ddomurad/dd8/hardware/gfx_module/README.md

GFX_DMA - Direct Memory Access circuit. Responsible for copping data from CPU RAM into Video RAM.
GFX_VGA - VGA signal generator circuit. Responsible for dumping Video RAM data to VGA display. 
Video RAM - 64KB of RAM that stores the pixel data for the VGA display.
Color Palette RAM - 1K of RAM that stores the color palette for the VGA display.
