ddomurad/dd8/hardware/gfx_module/docs/insp/NewFile1.csv

X | CH1 | CH2 | CH3 | CH4 | Start | Increment
Sequence | Volt | Volt | Volt | Volt | -6.000000e-07 | 1.000000e-09
0 | 4.96e+00 | 2.24e+00 | 8.00e-01 | -1.20e+00
1 | 4.96e+00 | 2.24e+00 | 8.00e-01 | -1.20e+00
2 | 4.80e+00 | 2.48e+00 | 2.08e+00 | -1.28e+00
3 | 4.80e+00 | 2.48e+00 | 2.08e+00 | -1.28e+00
4 | 4.64e+00 | 3.20e+00 | 2.80e+00 | -1.44e+00
5 | 4.64e+00 | 3.20e+00 | 2.80e+00 | -1.44e+00
6 | 4.24e+00 | 3.92e+00 | 2.80e+00 | -1.28e+00
7 | 4.24e+00 | 3.92e+00 | 2.80e+00 | -1.28e+00
8 | 3.52e+00 | 4.16e+00 | 2.88e+00 | -8.00e-01
9 | 3.52e+00 | 4.16e+00 | 2.88e+00 | -8.00e-01
10 | 2.64e+00 | 4.24e+00 | 3.44e+00 | -3.20e-01
11 | 2.64e+00 | 4.24e+00 | 3.44e+00 | -3.20e-01
12 | 1.44e+00 | 4.32e+00 | 4.40e+00 | -2.40e-01
13 | 1.44e+00 | 4.32e+00 | 4.40e+00 | -2.40e-01
14 | 4.80e-01 | 4.64e+00 | 4.88e+00 | -3.20e-01
15 | 4.80e-01 | 4.64e+00 | 4.88e+00 | -3.20e-01
16 | -8.00e-02 | 4.80e+00 | 4.72e+00 | -3.20e-01
17 | -8.00e-02 | 4.80e+00 | 4.72e+00 | -3.20e-01
18 | -3.20e-01 | 4.72e+00 | 4.56e+00 | 8.00e-02
19 | -3.20e-01 | 4.72e+00 | 4.56e+00 | 8.00e-02
20 | -1.60e-01 | 4.56e+00 | 4.40e+00 | 4.80e-01
21 | -1.60e-01 | 4.56e+00 | 4.40e+00 | 4.80e-01
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
