ddomurad/dd8/hardware/gfx_module/docs/insp/NewFile2.csv

X | CH1 | CH2 | CH3 | CH4 | Start | Increment
Sequence | Volt | Volt | Volt | Volt | -6.000000e-07 | 4.000000e-09
0 | 8.00e-01 | -1.12e+00 | -1.68e+00 | 3.52e+00
1 | -4.00e-01 | -1.04e+00 | -1.28e+00 | 3.52e+00
2 | 8.00e-02 | -7.20e-01 | -9.60e-01 | 2.96e+00
3 | 6.40e-01 | -5.60e-01 | -8.00e-01 | 2.40e+00
4 | 2.16e+00 | -2.40e-01 | 0.00e+00 | 2.32e+00
5 | 4.40e+00 | 2.40e-01 | -1.60e-01 | 1.60e-01
6 | 4.96e+00 | 1.92e+00 | -4.00e-01 | -1.12e+00
7 | 4.80e+00 | 2.40e+00 | 2.08e+00 | -1.28e+00
8 | 4.24e+00 | 3.84e+00 | 2.72e+00 | -1.28e+00
9 | 2.64e+00 | 4.16e+00 | 3.44e+00 | -3.20e-01
10 | 4.80e-01 | 4.56e+00 | 4.80e+00 | -3.20e-01
11 | -3.20e-01 | 4.64e+00 | 4.48e+00 | 8.00e-02
12 | 8.00e-02 | 4.40e+00 | 4.40e+00 | 8.80e-01
13 | 8.80e-01 | 3.84e+00 | 3.84e+00 | 7.20e-01
14 | 2.32e+00 | 3.36e+00 | 3.60e+00 | 4.80e-01
15 | 4.24e+00 | 3.12e+00 | 4.00e+00 | 1.84e+00
16 | 5.20e+00 | 8.80e-01 | 4.24e+00 | 2.96e+00
17 | 5.12e+00 | 7.20e-01 | 1.68e+00 | 3.44e+00
18 | 4.00e+00 | 3.20e-01 | 8.00e-01 | 3.68e+00
19 | 2.56e+00 | -5.60e-01 | 3.20e-01 | 3.68e+00
20 | 8.00e-01 | -1.12e+00 | -1.68e+00 | 3.52e+00
21 | -4.00e-01 | -1.04e+00 | -1.28e+00 | 3.52e+00
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
