ddomurad/dd8/hardware/0v2/doc/ic_selector.png

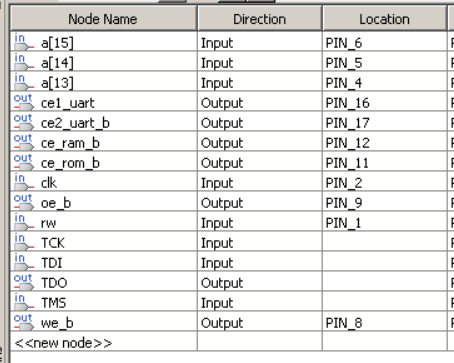
hardware/0v2/doc/ic_selector.png
