ddomurad/dd8/hardware/gfx_module/docs/addr_mux.png

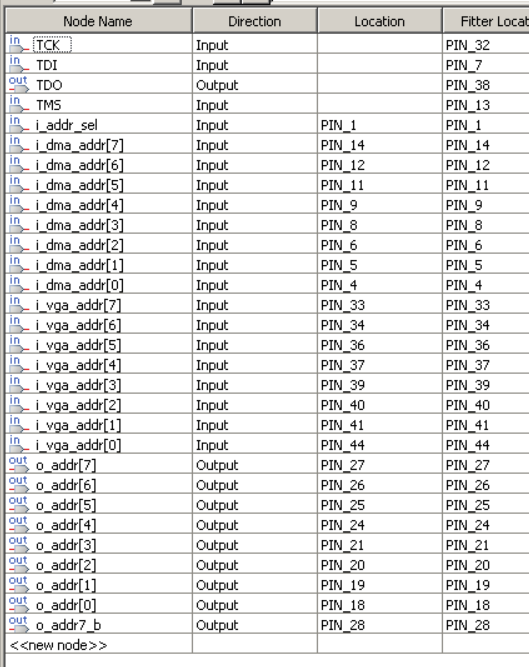
hardware/gfx_module/docs/addr_mux.png
