ddomurad/dd8/hardware/gfx_module/docs/dma_1.png

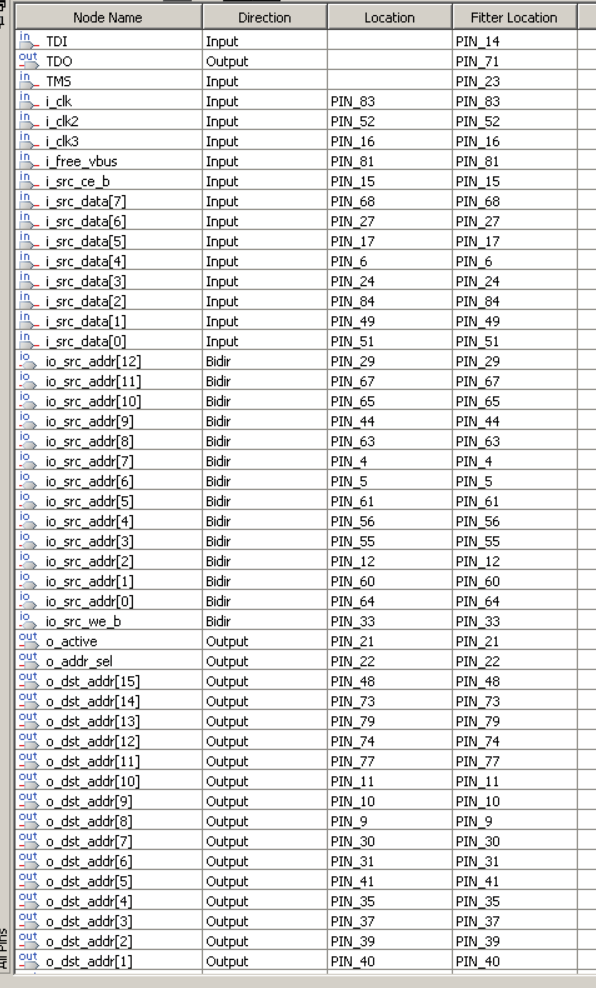
hardware/gfx_module/docs/dma_1.png
