ddomurad/dd8/hardware/gfx_module/docs/insp/NewFile1.png

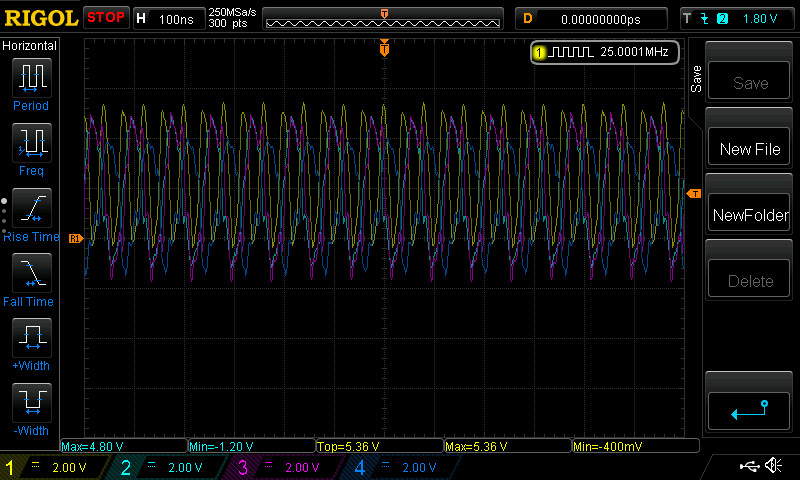
hardware/gfx_module/docs/insp/NewFile1.png
