ddomurad/dd8/hardware/gfx_module/docs/insp/scr1.png

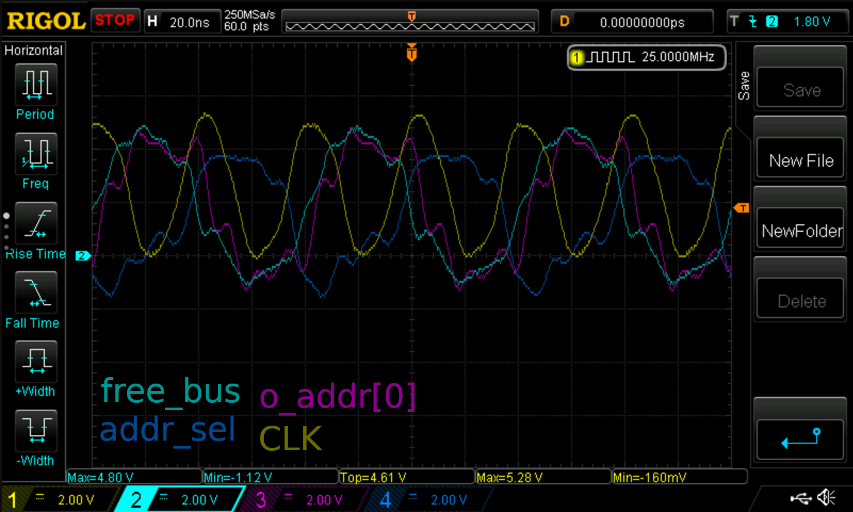
hardware/gfx_module/docs/insp/scr1.png
