ddomurad/dd8/hardware/gfx_module/docs/other/dma_vga-2.png

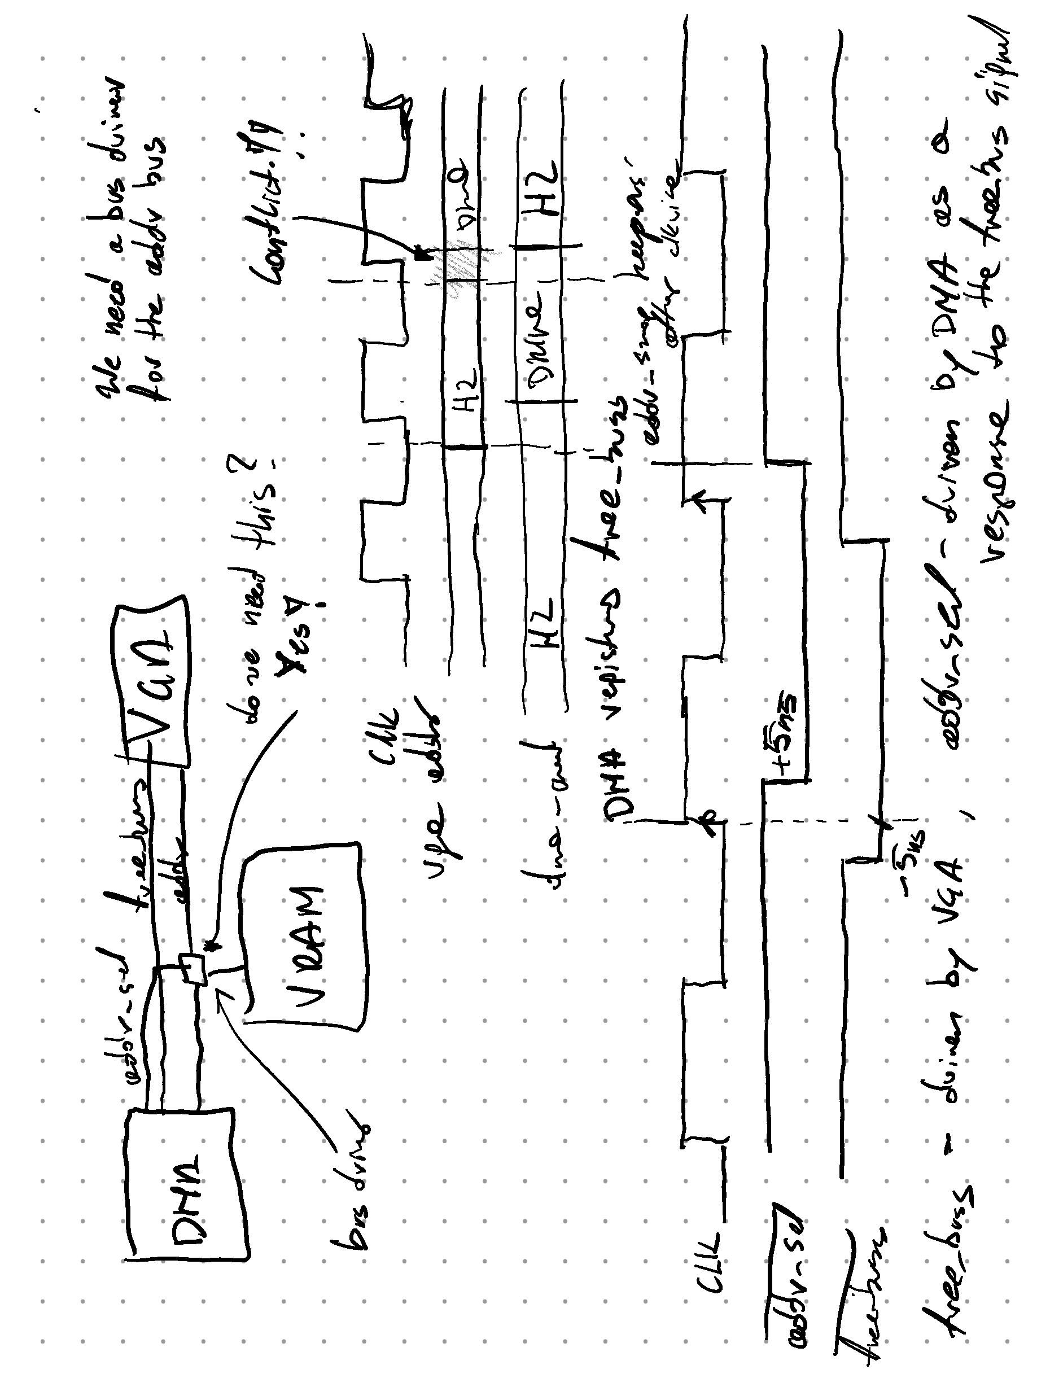
hardware/gfx_module/docs/other/dma_vga-2.png
