ddomurad/dd8/hardware/gfx_module/docs/other/dma_vga-3.png

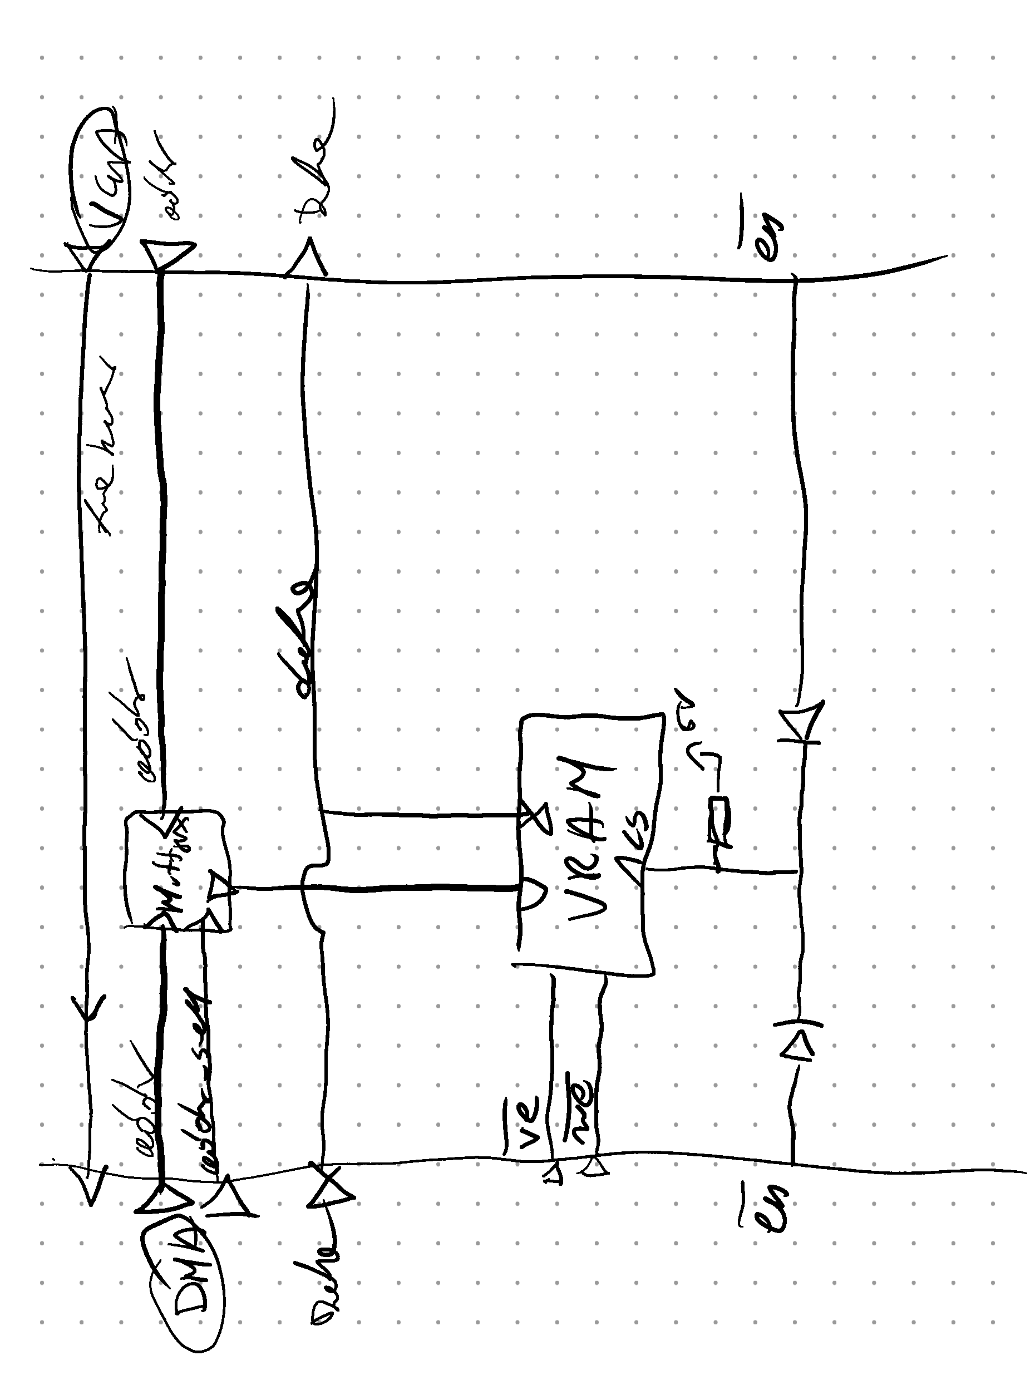
hardware/gfx_module/docs/other/dma_vga-3.png
