ddomurad/dd8/hardware/gfx_module/docs/other/dma_vga-4.png

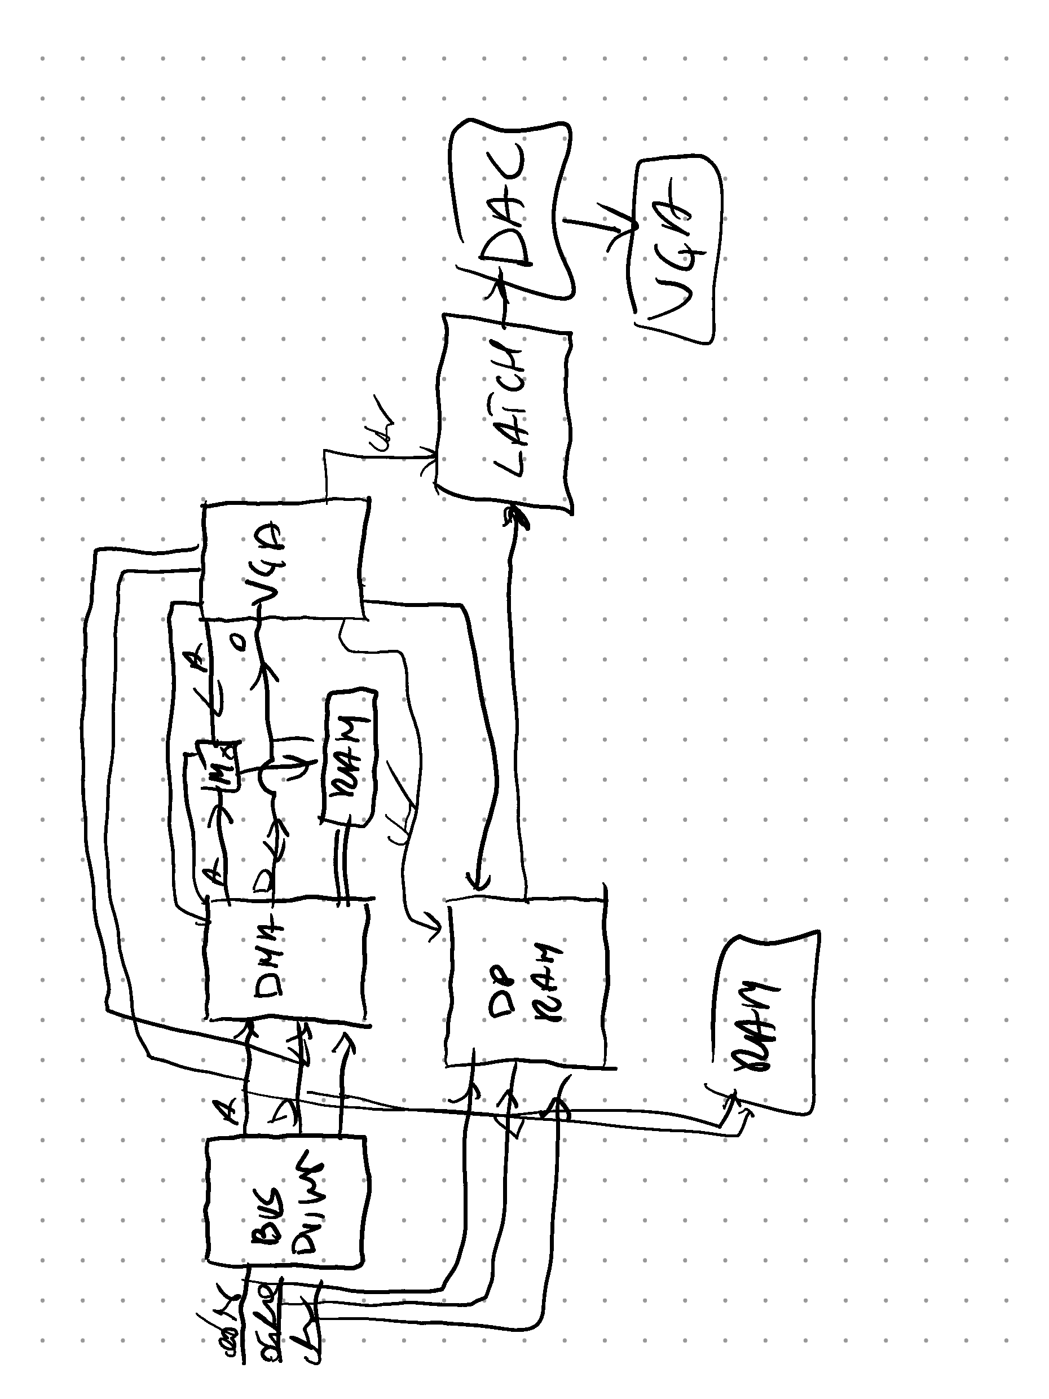
hardware/gfx_module/docs/other/dma_vga-4.png
