ddomurad/dd8/hardware/gfx_module/docs/vga_1.png

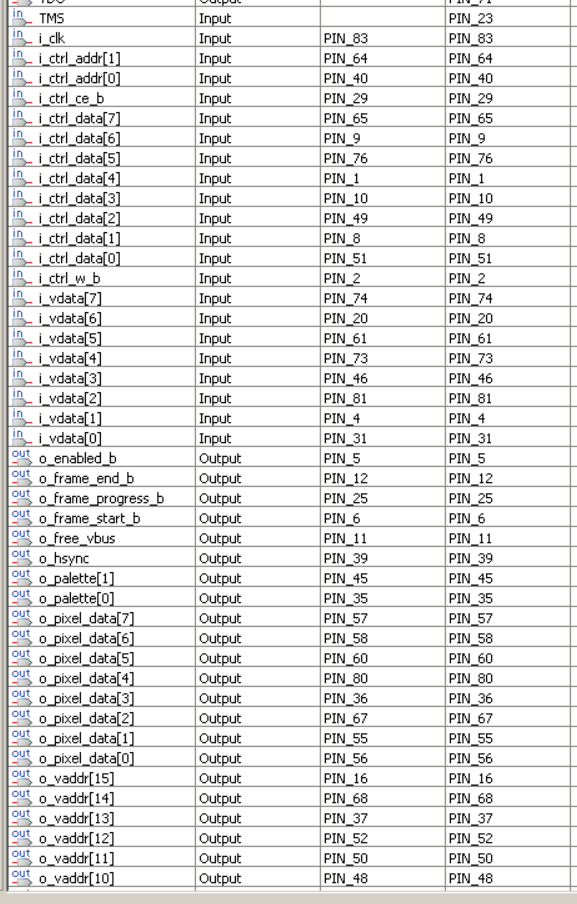
hardware/gfx_module/docs/vga_1.png
