ddomurad/dd8/hardware/gfx_module/docs/vga_2.png

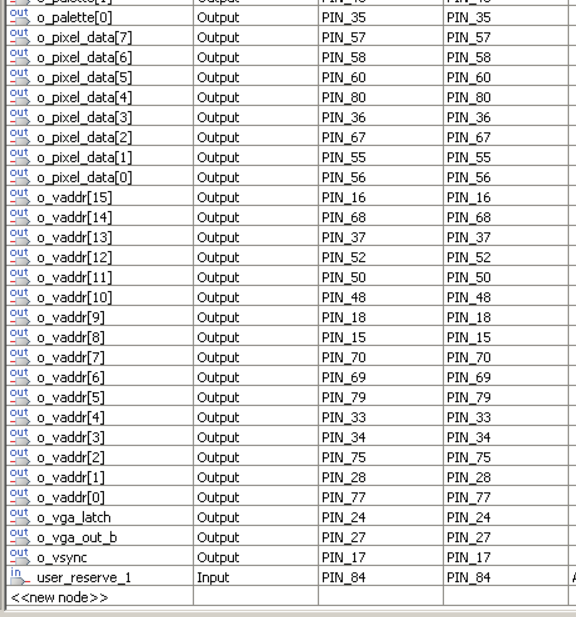
hardware/gfx_module/docs/vga_2.png
