ddomurad/dd8/hardware/kicad/dd8_computer/dd8_computer.pdf

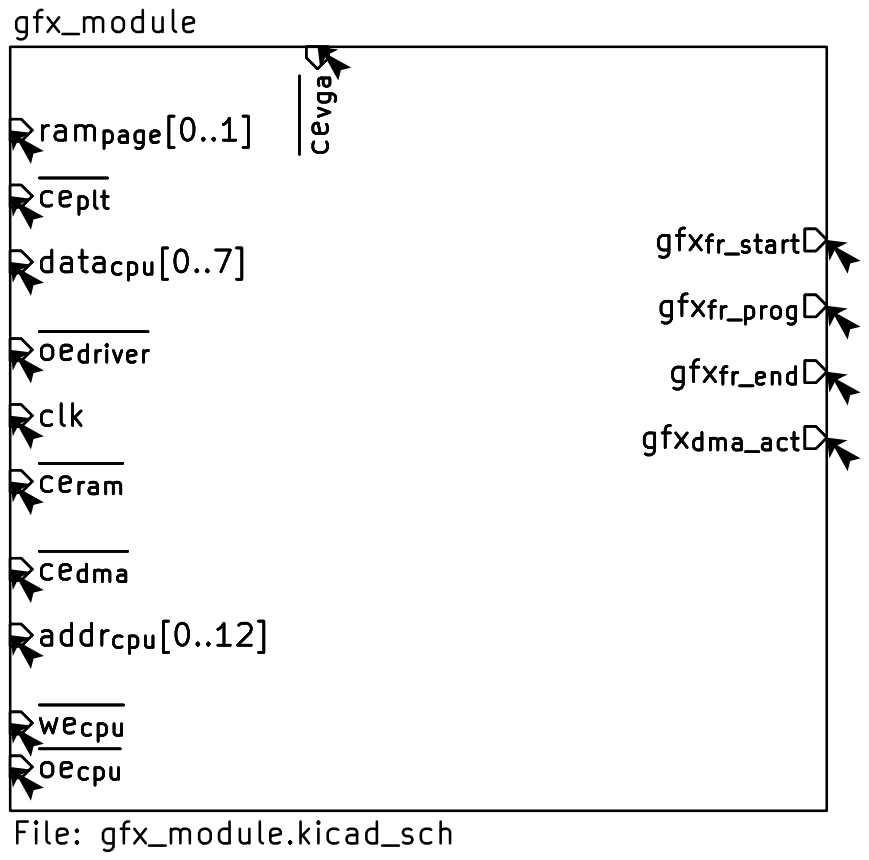
[picture p12: page 1]

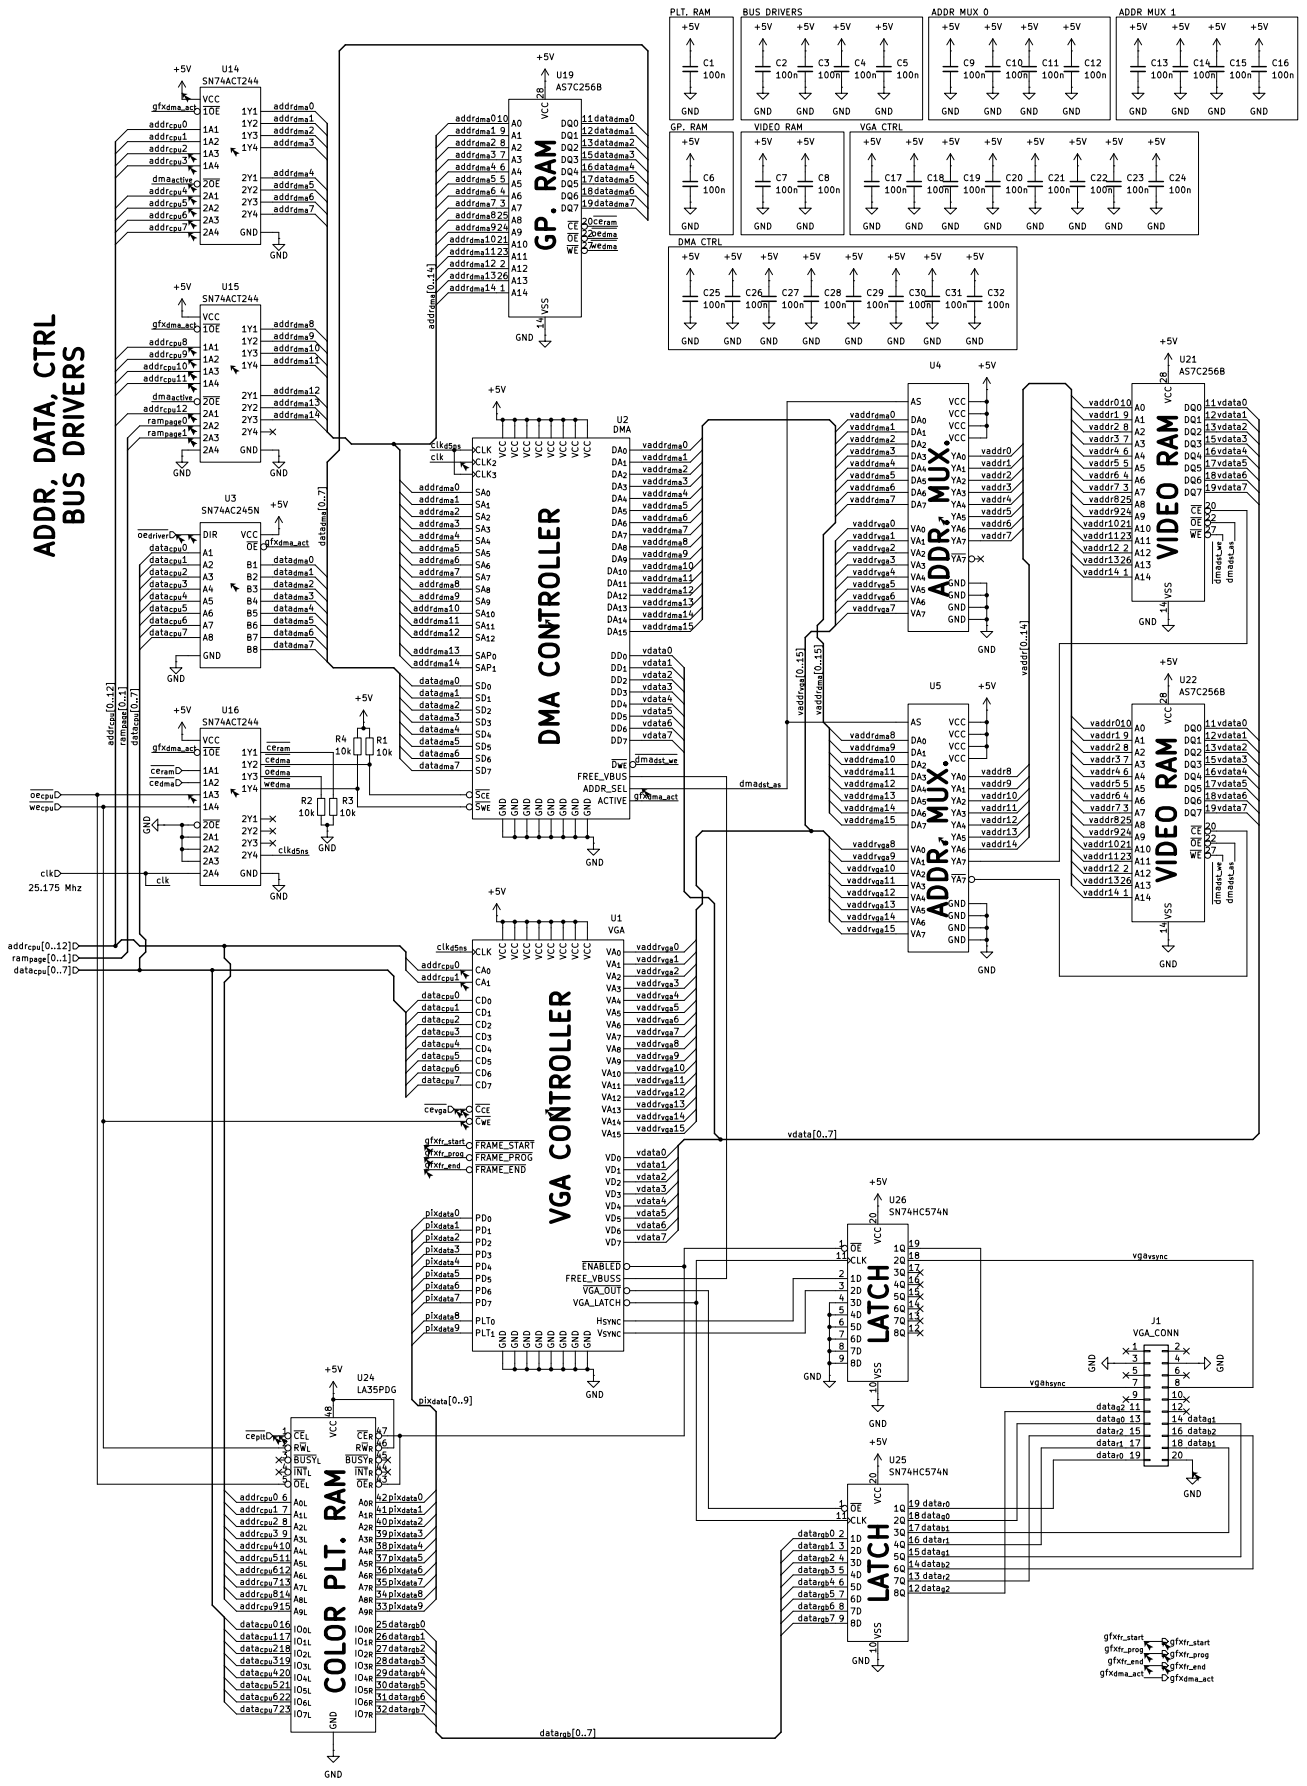
[picture p13: page 2]
