ddomurad/dd8/(list of files, drawings)

Other design files:
hardware/0v2/dd8_0v2/freerouting.dsn
