ddomurad/dd8/tools/hardware/EPMDevBoard/EpmDevBoard/EpmDevBoard.kicad_pcb

## KiCad design tools/hardware/EPMDevBoard/EpmDevBoard/EpmDevBoard.kicad_pcb (2024-11-05)

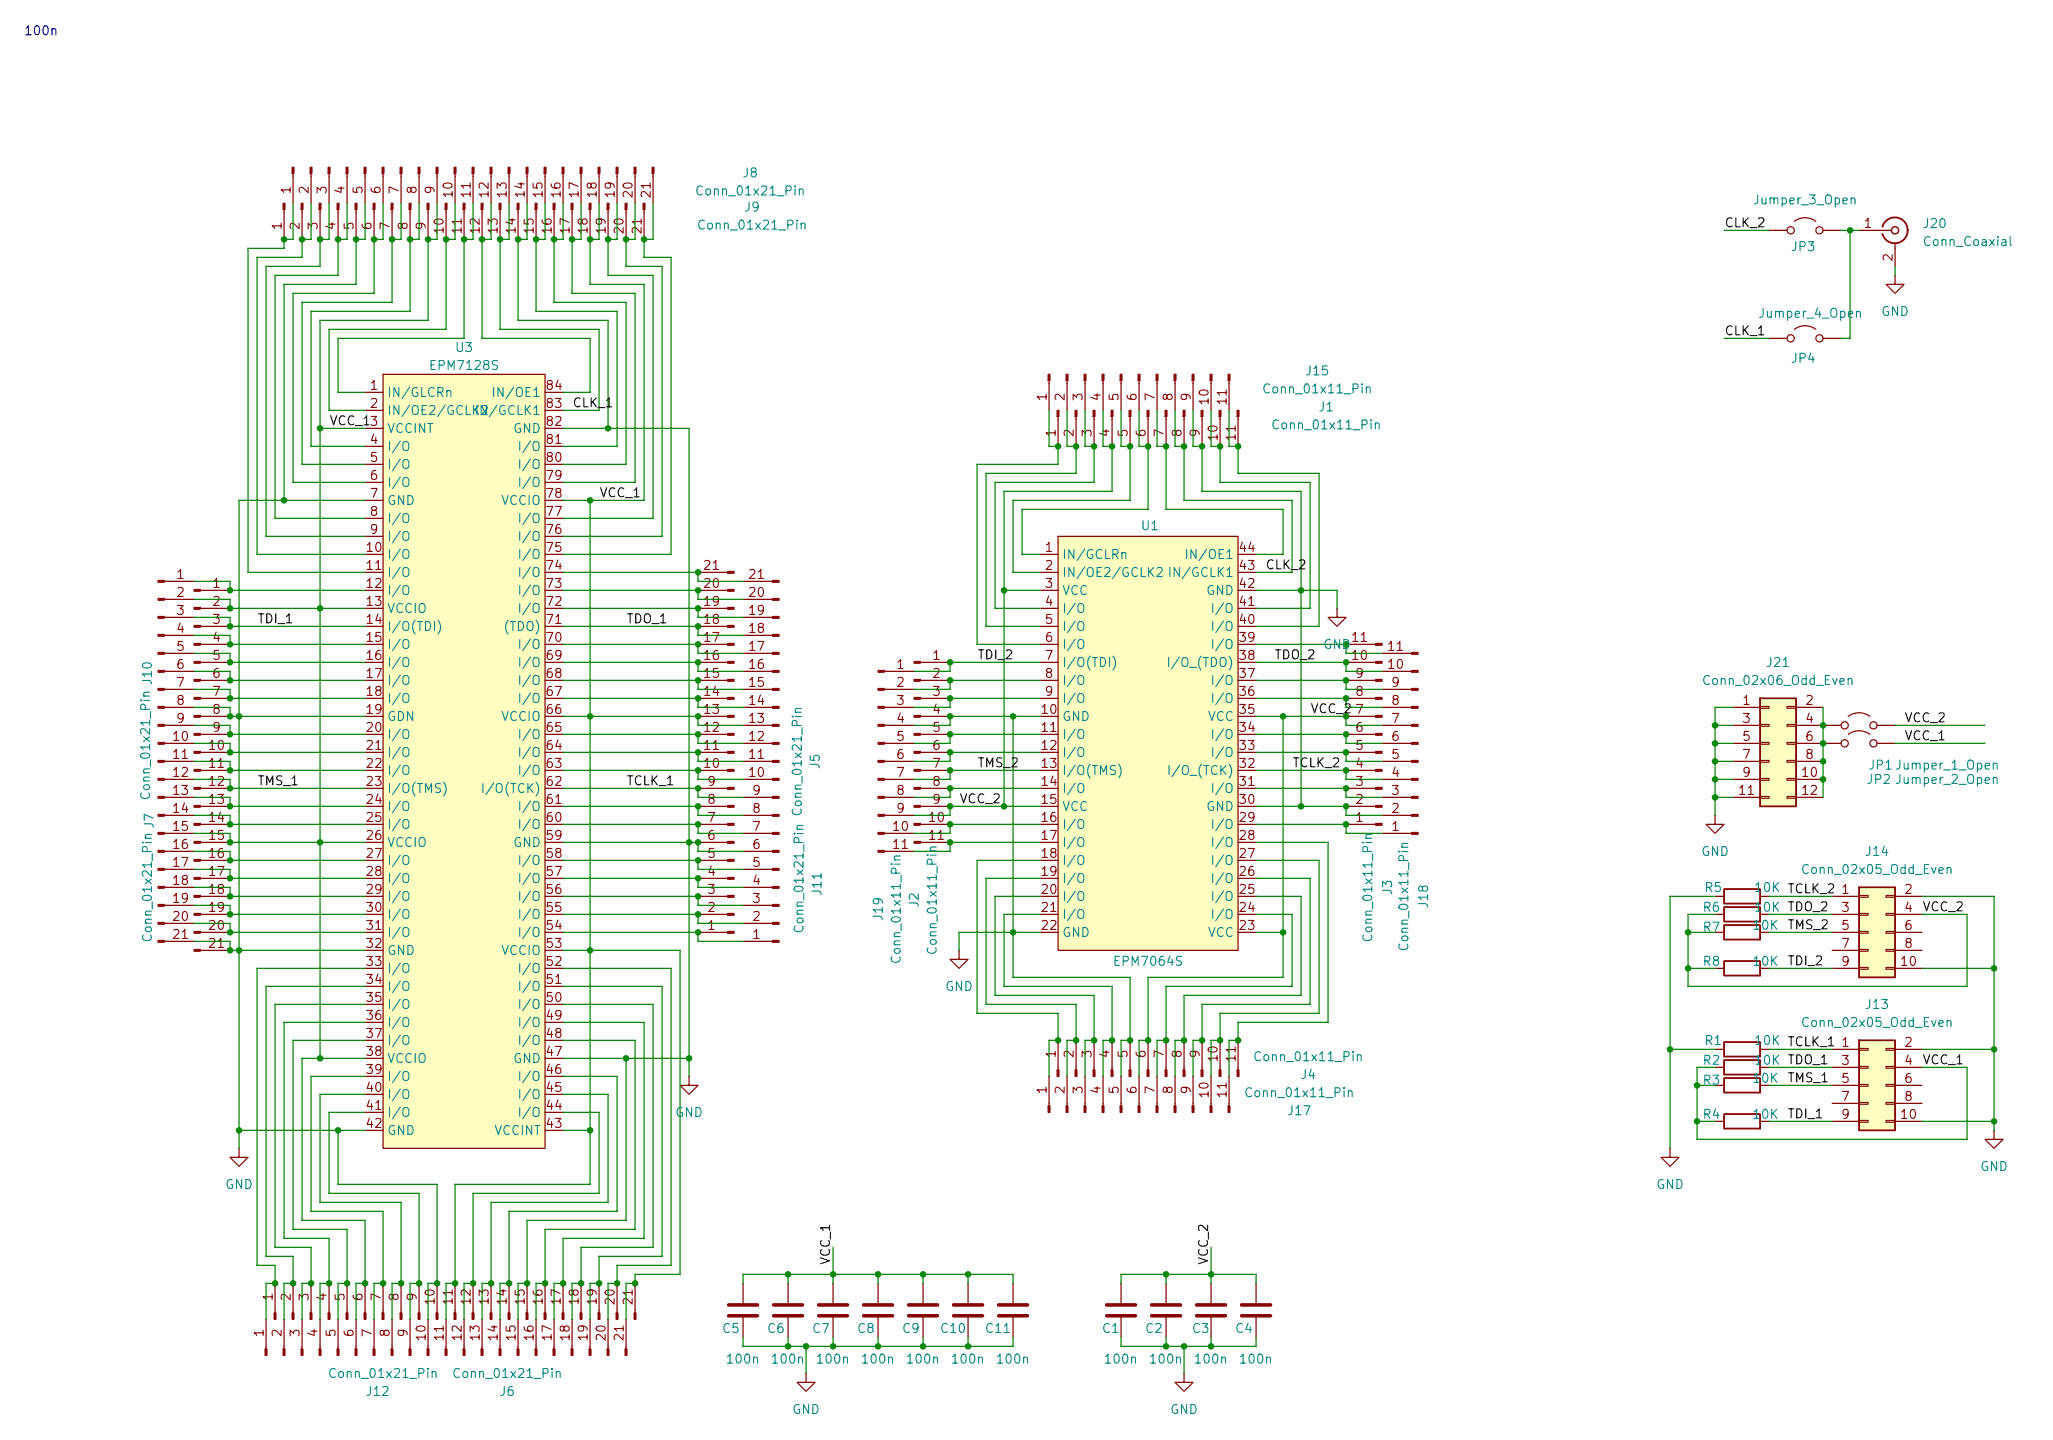
[picture p14: schematic EpmDevBoard.kicad_sch]

Parts:
C1, C2, C3, C4, C5, C6, C7, C8, C9, C10, C11: 100n; C_Disc_D3.0mm_W1.6mm_P2.50mm
J1, J2, J3, J4, J15, J17, J18, J19: Conn_01x11_Pin; PinHeader_1x11_P2.54mm_Vertical
J5, J6, J7, J8, J9, J10, J11, J12: Conn_01x21_Pin; PinSocket_1x21_P2.54mm_Vertical
J13, J14: Conn_02x05_Odd_Even; IDC-Header_2x05_P2.54mm_Vertical
J20: Conn_Coaxial; BNC_Amphenol_B6252HB-NPP3G-50_Horizontal
J21: Conn_02x06_Odd_Even; PinHeader_2x06_P2.54mm_Vertical
JP1: Jumper_1_Open; PinHeader_2x01_P2.54mm_Vertical
JP2: Jumper_2_Open; PinHeader_2x01_P2.54mm_Vertical
JP3: Jumper_3_Open; SolderJumper-2_P1.3mm_Open_Pad1.0x1.5mm
JP4: Jumper_4_Open; SolderJumper-2_P1.3mm_Open_Pad1.0x1.5mm
R1, R2, R3, R4, R5, R6, R7, R8: 10K; R_Axial_DIN0204_L3.6mm_D1.6mm_P5.08mm_Horizontal
U1: EPM7064S; PLCC-44_THT-Socket
U3: EPM7128S; PLCC-84_THT-Socket

Connections:
/CLK_1: J8.13, J9.13, JP4.1 (A), U3.83 (IN/GCLK1)
/CLK_2: J1.8, J15.8, JP3.1 (A), U1.43 (IN/GCLK1)
/TCLK_1: J5.9, J11.9, J13.1, R1.2, U3.62 (I/O(TCK))
/TCLK_2: J3.4, J14.1, J18.4, R5.2, U1.32 (I/O_(TCK))
/TDI_1: J7.3, J10.3, J13.9, R4.2, U3.14 (I/O(TDI))
/TDI_2: J2.1, J14.9, J19.1, R8.2, U1.7 (I/O(TDI))
/TDO_1: J5.18, J11.18, J13.3, R2.2, U3.71 ((TDO))
/TDO_2: J3.10, J14.3, J18.10, R6.2, U1.38 (I/O_(TDO))
/TMS_1: J7.12, J10.12, J13.5, R3.2, U3.23 (I/O(TMS))
/TMS_2: J2.7, J14.5, J19.7, R7.2, U1.13 (I/O(TMS))
/VCC_1: C5.1, C6.1, C7.1, C8.1, C9.1, C10.1, C11.1, J5.13, J6.6, J6.11, J6.21, J7.2, J7.15, J8.9, J8.18, J9.9, J9.18, J10.2, J10.15, J11.13, J12.6, J12.11, J12.21, J13.4, JP2.2 (B), R2.1, R3.1, R4.1, U3.3 (VCCINT), U3.13 (VCCIO), U3.26 (VCCIO), U3.38 (VCCIO), U3.43 (VCCINT), U3.53 (VCCIO), U3.66 (VCCIO), U3.78 (VCCIO)
/VCC_2: C1.1, C2.1, C3.1, C4.1, J1.4, J2.9, J3.7, J4.6, J14.4, J15.4, J17.6, J18.7, J19.9, JP1.2 (B), R6.1, R7.1, R8.1, U1.3 (VCC), U1.15 (VCC), U1.23 (VCC), U1.35 (VCC)
GND: C1.2, C2.2, C3.2, C4.2, C5.2, C6.2, C7.2, C8.2, C9.2, C10.2, C11.2, J1.9, J2.4, J3.2, J4.5, J5.6, J6.10, J6.15, J7.8, J7.21, J8.5, J8.14, J9.5, J9.14, J10.8, J10.21, J11.6, J12.10, J12.15, J13.2, J13.10, J14.2, J14.10, J15.9, J17.5, J18.2, J19.4, J20.2 (Ext), J21.1, J21.3, J21.5, J21.7, J21.9, J21.11, R1.1, R5.1, U1.10 (GND), U1.22 (GND), U1.30 (GND), U1.42 (GND), U3.7 (GND), U3.19 (GDN), U3.32 (GND), U3.42 (GND), U3.47 (GND), U3.59 (GND), U3.82 (GND)
unnamed: J1.1, J15.1, U1.6 (I/O)
unnamed: J1.2, J15.2, U1.5 (I/O)
unnamed: J1.3, J15.3, U1.4 (I/O)
unnamed: J1.5, J15.5, U1.2 (IN/OE2/GCLK2)
unnamed: J1.6, J15.6, U1.1 (IN/GCLRn)
unnamed: J1.7, J15.7, U1.44 (IN/OE1)
unnamed: J1.10, J15.10, U1.41 (I/O)
unnamed: J1.11, J15.11, U1.40 (I/O)
unnamed: J8.1, J9.1, U3.11 (I/O)
unnamed: J8.2, J9.2, U3.10 (I/O)
unnamed: J8.3, J9.3, U3.9 (I/O)
unnamed: J8.4, J9.4, U3.8 (I/O)
unnamed: J8.6, J9.6, U3.6 (I/O)
unnamed: J8.7, J9.7, U3.5 (I/O)
unnamed: J8.8, J9.8, U3.4 (I/O)
unnamed: J8.10, J9.10, U3.2 (IN/OE2/GCLK2)
unnamed: J8.11, J9.11, U3.1 (IN/GLCRn)
unnamed: J8.12, J9.12, U3.84 (IN/OE1)
unnamed: J8.15, J9.15, U3.81 (I/O)
unnamed: J8.16, J9.16, U3.80 (I/O)
unnamed: J8.17, J9.17, U3.79 (I/O)
unnamed: J8.19, J9.19, U3.77 (I/O)
unnamed: J8.20, J9.20, U3.76 (I/O)
unnamed: J8.21, J9.21, U3.75 (I/O)
unnamed: J7.1, J10.1, U3.12 (I/O)
unnamed: J7.4, J10.4, U3.15 (I/O)
unnamed: J7.5, J10.5, U3.16 (I/O)
unnamed: J7.6, J10.6, U3.17 (I/O)
unnamed: J7.7, J10.7, U3.18 (I/O)
unnamed: J7.9, J10.9, U3.20 (I/O)
unnamed: J7.10, J10.10, U3.21 (I/O)
unnamed: J7.11, J10.11, U3.22 (I/O)
unnamed: J7.13, J10.13, U3.24 (I/O)
unnamed: J7.14, J10.14, U3.25 (I/O)
unnamed: J7.16, J10.16, U3.27 (I/O)
unnamed: J7.17, J10.17, U3.28 (I/O)
unnamed: J7.18, J10.18, U3.29 (I/O)
unnamed: J7.19, J10.19, U3.30 (I/O)
unnamed: J7.20, J10.20, U3.31 (I/O)
unnamed: J5.1, J11.1, U3.54 (I/O)
unnamed: J5.2, J11.2, U3.55 (I/O)
unnamed: J5.3, J11.3, U3.56 (I/O)
unnamed: J5.4, J11.4, U3.57 (I/O)
unnamed: J5.5, J11.5, U3.58 (I/O)
unnamed: J5.7, J11.7, U3.60 (I/O)
unnamed: J5.8, J11.8, U3.61 (I/O)
unnamed: J5.10, J11.10, U3.63 (I/O)
unnamed: J5.11, J11.11, U3.64 (I/O)
unnamed: J5.12, J11.12, U3.65 (I/O)
unnamed: J5.14, J11.14, U3.67 (I/O)
unnamed: J5.15, J11.15, U3.68 (I/O)
unnamed: J5.16, J11.16, U3.69 (I/O)
unnamed: J5.17, J11.17, U3.70 (I/O)
unnamed: J5.19, J11.19, U3.72 (I/O)
unnamed: J5.20, J11.20, U3.73 (I/O)
unnamed: J5.21, J11.21, U3.74 (I/O)
unnamed: J6.1, J12.1, U3.33 (I/O)
unnamed: J6.2, J12.2, U3.34 (I/O)
unnamed: J6.3, J12.3, U3.35 (I/O)
unnamed: J6.4, J12.4, U3.36 (I/O)
unnamed: J6.5, J12.5, U3.37 (I/O)
unnamed: J6.7, J12.7, U3.39 (I/O)
unnamed: J6.8, J12.8, U3.40 (I/O)
unnamed: J6.9, J12.9, U3.41 (I/O)
unnamed: J6.12, J12.12, U3.44 (I/O)
unnamed: J6.13, J12.13, U3.45 (I/O)
unnamed: J6.14, J12.14, U3.46 (I/O)
unnamed: J6.16, J12.16, U3.48 (I/O)
unnamed: J6.17, J12.17, U3.49 (I/O)
unnamed: J6.18, J12.18, U3.50 (I/O)
unnamed: J6.19, J12.19, U3.51 (I/O)
unnamed: J6.20, J12.20, U3.52 (I/O)
unnamed: J4.1, J17.1, U1.18 (I/O)
unnamed: J4.2, J17.2, U1.19 (I/O)
unnamed: J4.3, J17.3, U1.20 (I/O)
unnamed: J4.4, J17.4, U1.21 (I/O)
unnamed: J4.7, J17.7, U1.24 (I/O)
unnamed: J4.8, J17.8, U1.25 (I/O)
unnamed: J4.9, J17.9, U1.26 (I/O)
unnamed: J4.10, J17.10, U1.27 (I/O)
unnamed: J4.11, J17.11, U1.28 (I/O)
unnamed: J3.1, J18.1, U1.29 (I/O)
unnamed: J3.3, J18.3, U1.31 (I/O)
unnamed: J3.5, J18.5, U1.33 (I/O)
unnamed: J3.6, J18.6, U1.34 (I/O)
unnamed: J3.8, J18.8, U1.36 (I/O)
unnamed: J3.9, J18.9, U1.37 (I/O)
unnamed: J3.11, J18.11, U1.39 (I/O)
unnamed: J2.2, J19.2, U1.8 (I/O)
unnamed: J2.3, J19.3, U1.9 (I/O)
unnamed: J2.5, J19.5, U1.11 (I/O)
unnamed: J2.6, J19.6, U1.12 (I/O)
unnamed: J2.8, J19.8, U1.14 (I/O)
unnamed: J2.10, J19.10, U1.16 (I/O)
unnamed: J2.11, J19.11, U1.17 (I/O)
unnamed: J20.1 (In), JP3.2 (B), JP4.2 (B)
unnamed: J21.2, J21.4, J21.6, J21.8, J21.10, J21.12, JP1.1 (A), JP2.1 (A)

Notes on the sheet:
100n

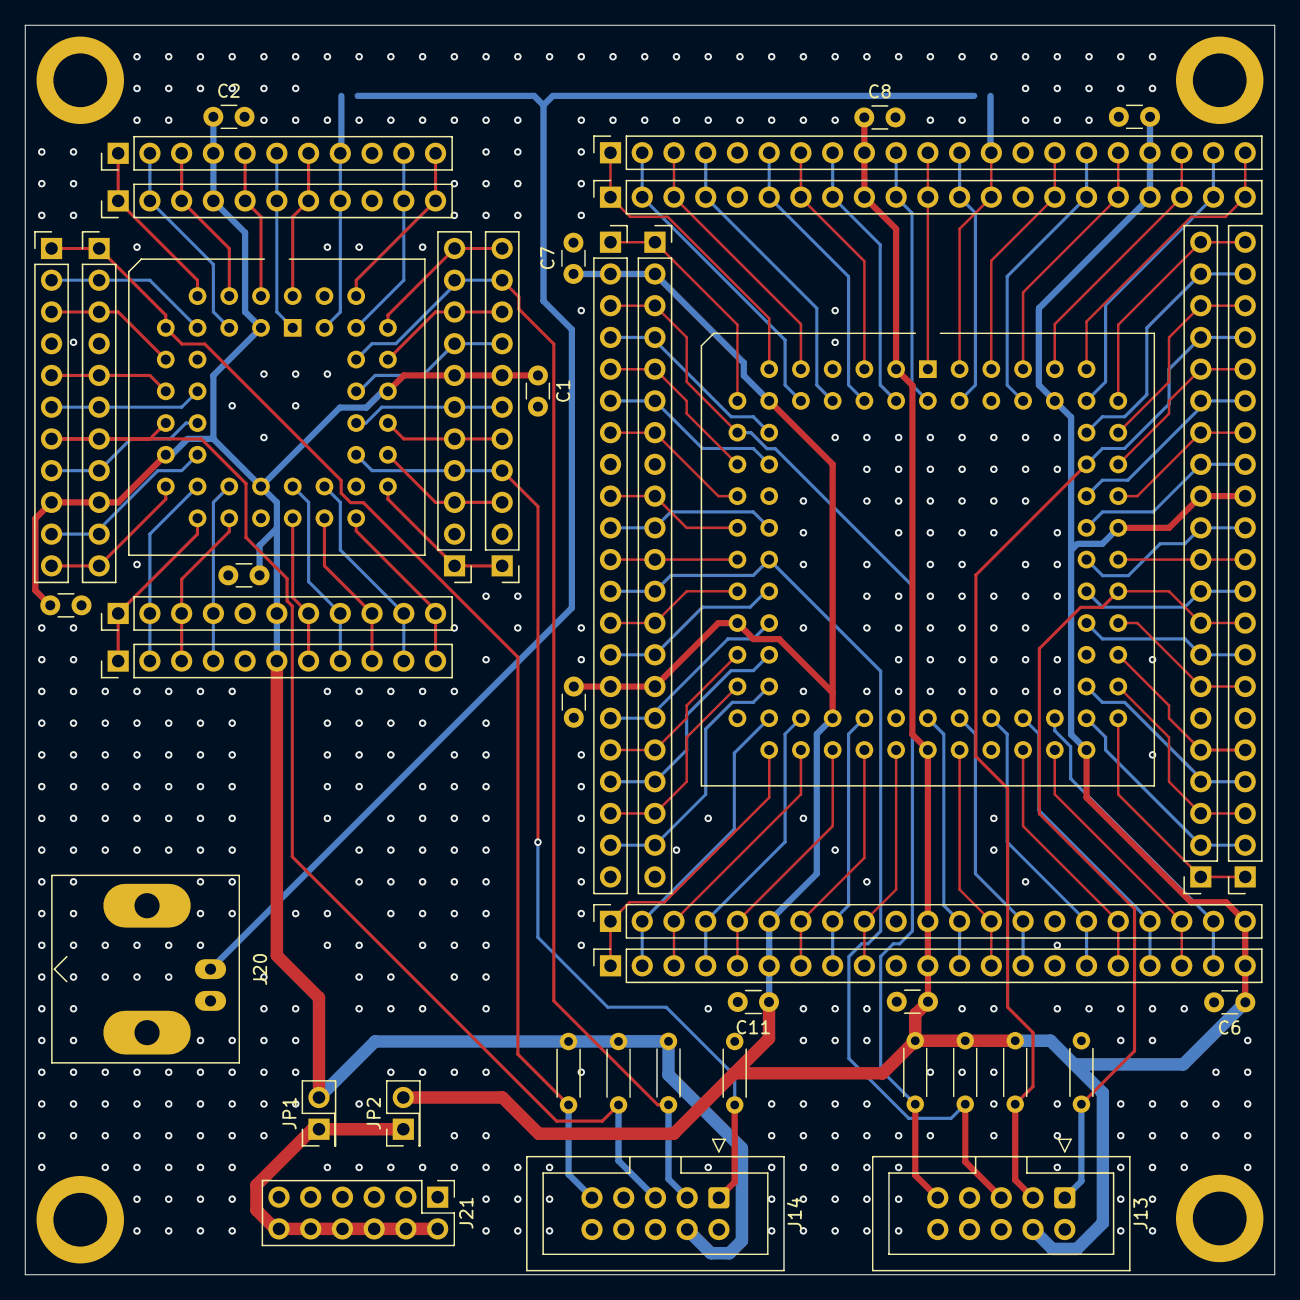
[picture p15: board EpmDevBoard.kicad_pcb from above]

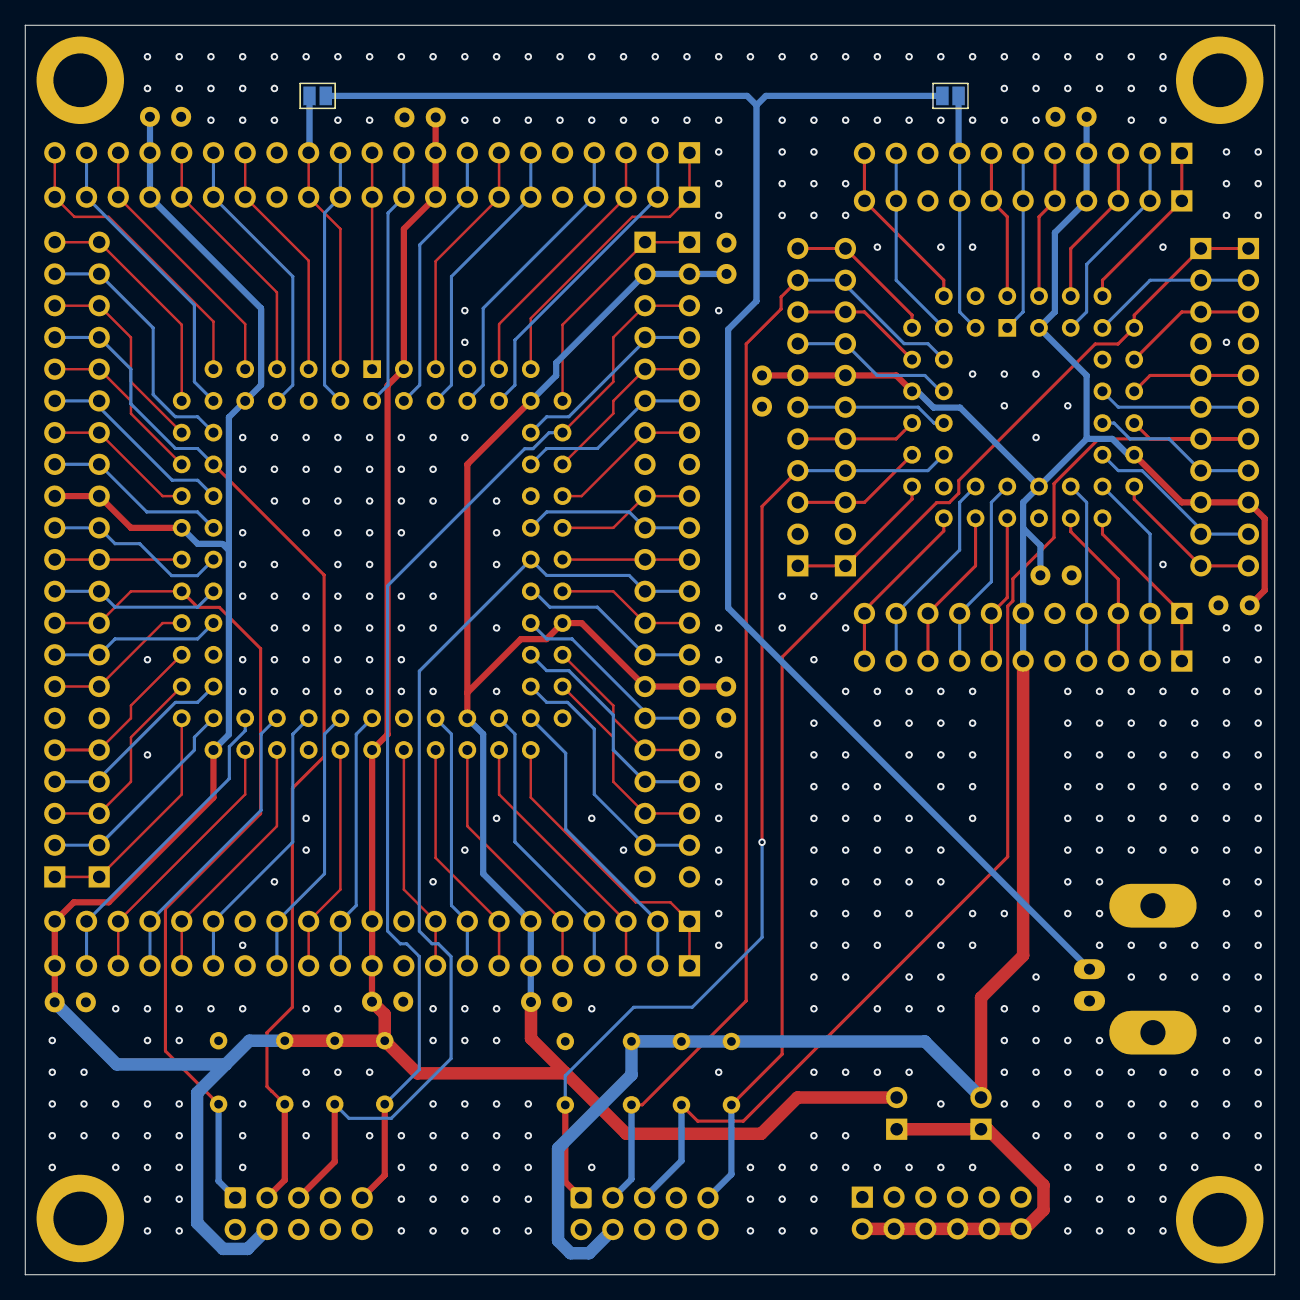
[picture p16: board EpmDevBoard.kicad_pcb from below]

Board: 4 copper layers, 100.0 x 100.0 mm, 45 parts (2 on the bottom side), 110 nets.
