ddomurad/dd8/hardware/0v2/dd8_0v2/dd8_0v2.kicad_pcb

## KiCad design hardware/0v2/dd8_0v2/dd8_0v2.kicad_pcb (2024-02-25)

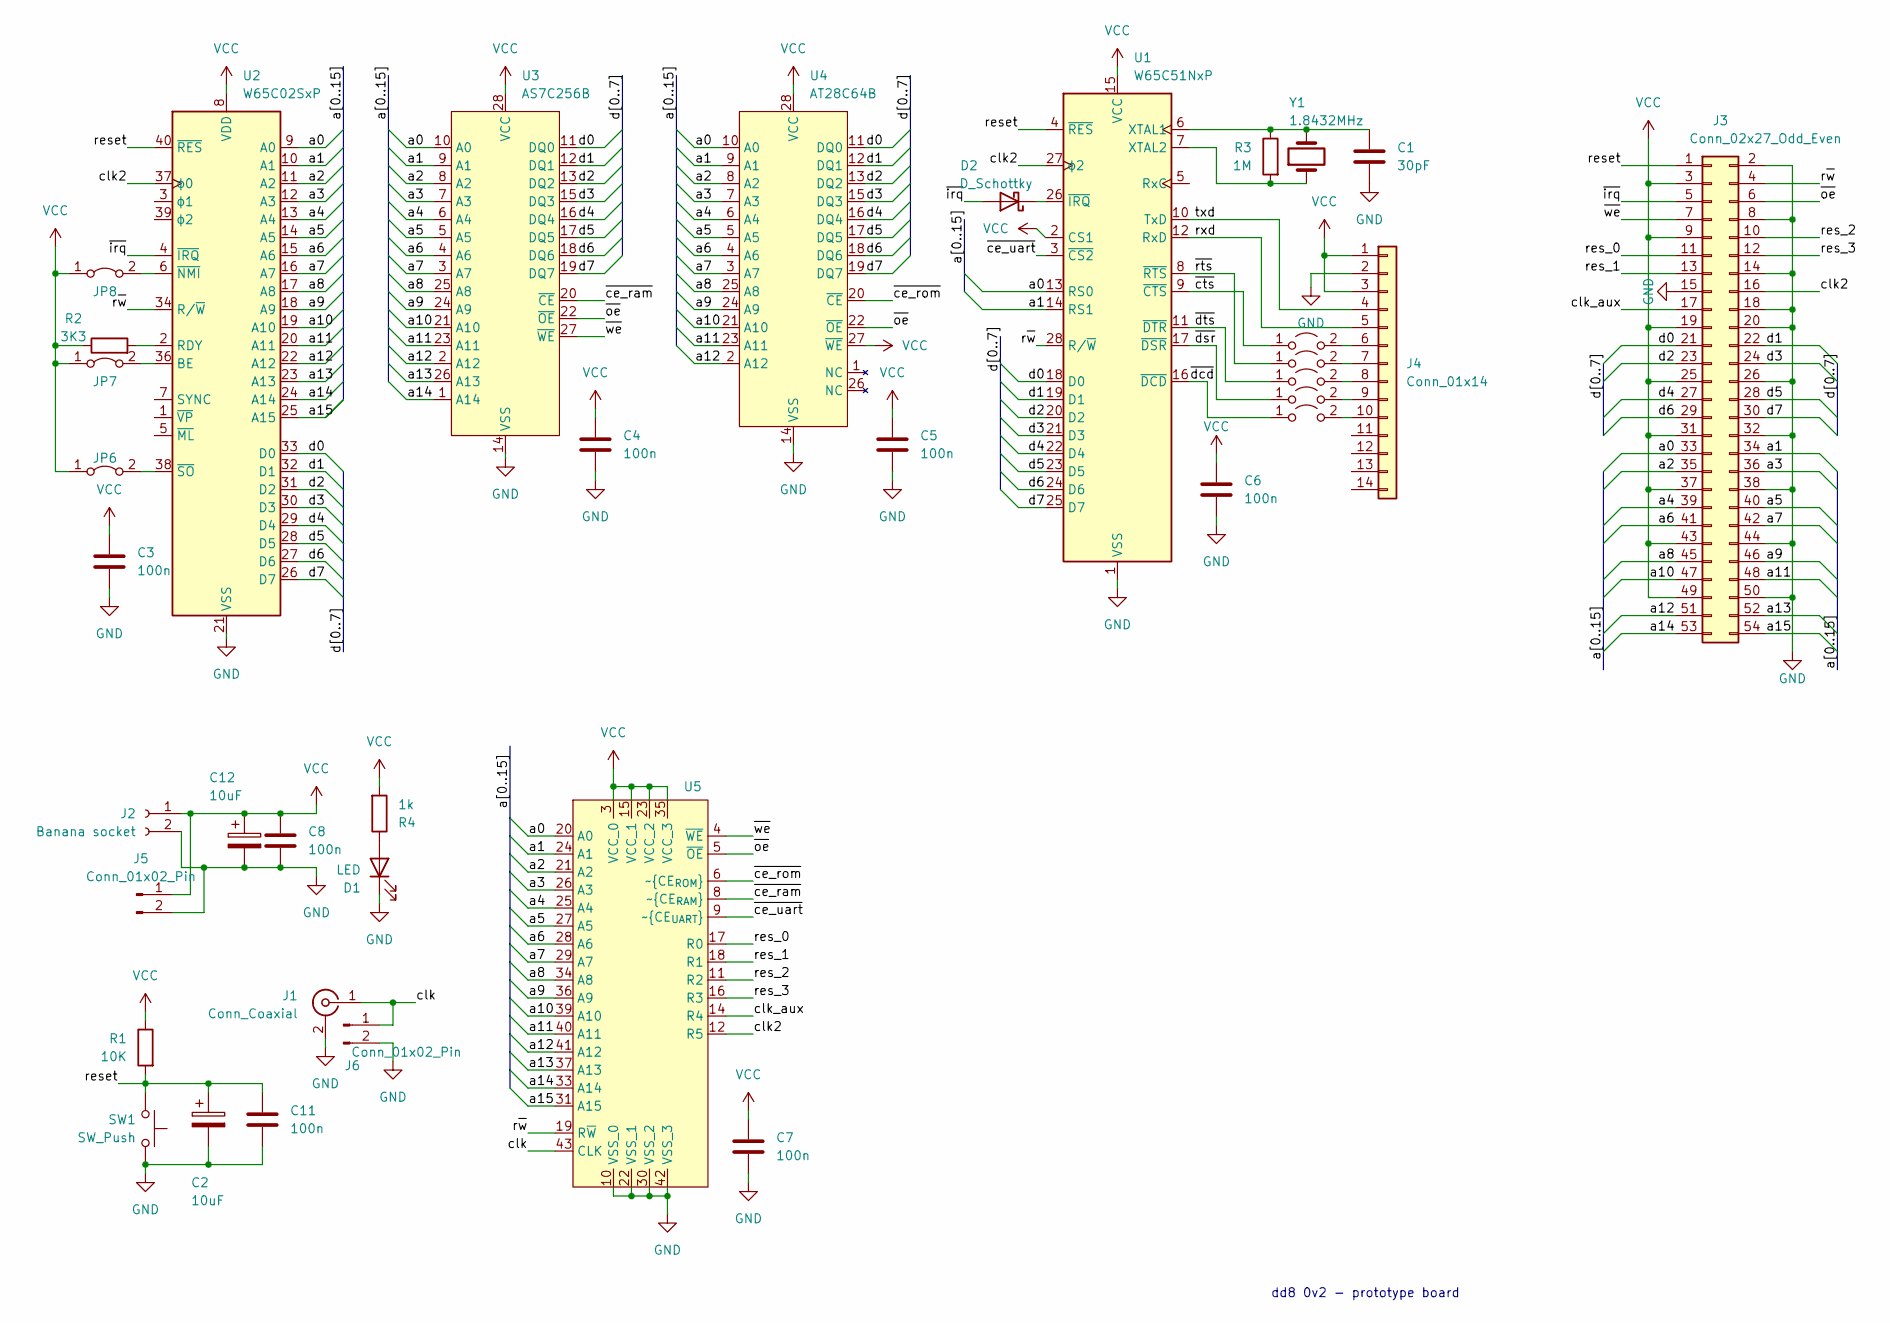
[picture p17: schematic dd8_0v2.kicad_sch]

Parts:
C1: 30pF; C_Disc_D3.0mm_W1.6mm_P2.50mm
C2, C12: 10uF; CP_Radial_D5.0mm_P2.50mm
C3, C4, C5, C6, C7, C8, C11: 100n; C_Disc_D3.0mm_W1.6mm_P2.50mm
D1: LED; LED_D3.0mm
D2: D_Schottky; D_DO-35_SOD27_P7.62mm_Horizontal
J1: Conn_Coaxial; BNC_Amphenol_B6252HB-NPP3G-50_Horizontal
J2: Banana socket; Bannana_Jack_2Pin
J3: Conn_02x27_Odd_Even; PinSocket_2x27_P2.54mm_Vertical
J4: Conn_01x14; PinHeader_2x07_P2.54mm_Vertical
J5, J6: Conn_01x02_Pin; PinSocket_1x02_P2.54mm_Vertical
JP1, JP2, JP3, JP4, JP5: Jumper_2_Open; SolderJumper-2_P1.3mm_Open_Pad1.0x1.5mm
JP6, JP7, JP8: Jumper_2_Bridged; PinHeader_1x02_P2.54mm_Vertical
R1: 10K; R_Axial_DIN0204_L3.6mm_D1.6mm_P2.54mm_Vertical
R2: 3K3; R_Axial_DIN0204_L3.6mm_D1.6mm_P2.54mm_Vertical
R3: 1M; R_Axial_DIN0204_L3.6mm_D1.6mm_P5.08mm_Horizontal
R4: 1k; R_Axial_DIN0204_L3.6mm_D1.6mm_P2.54mm_Vertical
SW1: SW_Push; SW_PUSH_6mm_H5mm
U1: W65C51NxP; DIP-28_W15.24mm
U2: W65C02SxP; DIP-40_W15.24mm
U3: AS7C256B; DIP-28_W7.62mm
U4: AT28C64B; DIP_Socket-28_W11.9_W12.7_W15.24_W17.78_W18.5_3M_228-1277-0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
U5: PLCC-44_THT-Socket
Y1: 1.8432MHz; Crystal_HC18-U_Vertical

Connections:
/a0: J3.33, U1.13 (RS0), U2.9 (A0), U3.10 (A0), U4.10 (A0), U5.20 (A0)
/a1: J3.34, U1.14 (RS1), U2.10 (A1), U3.9 (A1), U4.9 (A1), U5.24 (A1)
/a2: J3.35, U2.11 (A2), U3.8 (A2), U4.8 (A2), U5.21 (A2)
/a3: J3.36, U2.12 (A3), U3.7 (A3), U4.7 (A3), U5.26 (A3)
/a4: J3.39, U2.13 (A4), U3.6 (A4), U4.6 (A4), U5.25 (A4)
/a5: J3.40, U2.14 (A5), U3.5 (A5), U4.5 (A5), U5.27 (A5)
/a6: J3.41, U2.15 (A6), U3.4 (A6), U4.4 (A6), U5.28 (A6)
/a7: J3.42, U2.16 (A7), U3.3 (A7), U4.3 (A7), U5.29 (A7)
/a8: J3.45, U2.17 (A8), U3.25 (A8), U4.25 (A8), U5.34 (A8)
/a9: J3.46, U2.18 (A9), U3.24 (A9), U4.24 (A9), U5.36 (A9)
/a10: J3.47, U2.19 (A10), U3.21 (A10), U4.21 (A10), U5.39 (A10)
/a11: J3.48, U2.20 (A11), U3.23 (A11), U4.23 (A11), U5.40 (A11)
/a12: J3.51, U2.22 (A12), U3.2 (A12), U4.2 (A12), U5.41 (A12)
/a13: J3.52, U2.23 (A13), U3.26 (A13), U5.37 (A13)
/a14: J3.53, U2.24 (A14), U3.1 (A14), U5.33 (A14)
/a15: J3.54, U2.25 (A15), U5.31 (A15)
/clk: J1.1 (In), J6.1, U5.43 (CLK)
/clk2: J3.16, U1.27 (ϕ2), U2.37 (ϕ0), U5.12 (R5)
/clk_aux: J3.17, U5.14 (R4)
/d0: J3.21, U1.18 (D0), U2.33 (D0), U3.11 (DQ0), U4.11 (DQ0)
/d1: J3.22, U1.19 (D1), U2.32 (D1), U3.12 (DQ1), U4.12 (DQ1)
/d2: J3.23, U1.20 (D2), U2.31 (D2), U3.13 (DQ2), U4.13 (DQ2)
/d3: J3.24, U1.21 (D3), U2.30 (D3), U3.15 (DQ3), U4.15 (DQ3)
/d4: J3.27, U1.22 (D4), U2.29 (D4), U3.16 (DQ4), U4.16 (DQ4)
/d5: J3.28, U1.23 (D5), U2.28 (D5), U3.17 (DQ5), U4.17 (DQ5)
/d6: J3.29, U1.24 (D6), U2.27 (D6), U3.18 (DQ6), U4.18 (DQ6)
/d7: J3.30, U1.25 (D7), U2.26 (D7), U3.19 (DQ7), U4.19 (DQ7)
/res_0: J3.11, U5.17 (R0)
/res_1: J3.13, U5.18 (R1)
/res_2: J3.10, U5.11 (R2)
/res_3: J3.12, U5.16 (R3)
/reset: C2.1, C11.1, J3.1, R1.2, SW1.2, U1.4 (~RES), U2.40 (~RES)
/rxd: J4.5, U1.12 (RxD)
/r~w: J3.4, U1.28 (R/~W), U2.34 (R/~W), U5.19 (R~W)
/txd: J4.4, U1.10 (TxD)
/~ce_ram: U3.20 (~CE), U5.8 (~CE_{RAM})
/~ce_rom: U4.20 (~CE), U5.6 (~CE_{ROM})
/~ce_uart: U1.3 (~CS2), U5.9 (~CE_{UART})
/~cts: JP1.1 (A), U1.9 (~CTS)
/~dcd: JP5.1 (A), U1.16 (~DCD)
/~dsr: JP4.1 (A), U1.17 (~DSR)
/~dts: JP3.1 (A), U1.11 (~DTR)
/~irq: D2.2 (A), J3.5, U2.4 (~IRQ)
/~oe: J3.6, U3.22 (~OE), U4.22 (~OE), U5.5 (~OE)
/~rts: JP2.1 (A), U1.8 (~RTS)
/~we: J3.7, U3.27 (~WE), U5.4 (~WE)
GND: C1.2, C2.2, C3.2, C4.2, C5.2, C6.2, C7.2, C8.2, C11.2, C12.2, D1.1 (K), J1.2 (Ext), J2.2, J3.2, J3.8, J3.14, J3.15, J3.18, J3.20, J3.26, J3.32, J3.38, J3.44, J3.50, J4.2, J5.2, J6.2, SW1.1, U1.1 (VSS), U2.21 (VSS), U3.14 (VSS), U4.14 (VSS), U5.10 (VSS_0), U5.22 (VSS_1), U5.30 (VSS_2), U5.42 (VSS_3)
unnamed: D1.2 (A), R4.1
unnamed: D2.1 (K), U1.26 (~IRQ)
unnamed: J4.6, JP1.2 (B)
unnamed: J4.7, JP2.2 (B)
unnamed: J4.8, JP3.2 (B)
unnamed: J4.9, JP4.2 (B)
unnamed: J4.10, JP5.2 (B)
unnamed: JP6.2 (B), U2.38 (~SO)
unnamed: JP7.2 (B), U2.36 (BE)
unnamed: JP8.2 (B), U2.6 (~NMI)
unnamed: C1.1, R3.1, U1.6 (XTAL1), Y1.2
unnamed: R3.2, U1.7 (XTAL2), Y1.1
unnamed: R2.2, U2.2 (RDY)
VCC: C3.1, C4.1, C5.1, C6.1, C7.1, C8.1, C12.1, J2.1, J3.3, J3.9, J3.19, J3.25, J3.31, J3.37, J3.43, J3.49, J4.1, J4.3, J5.1, JP6.1 (A), JP7.1 (A), JP8.1 (A), R1.1, R2.1, R4.2, U1.2 (CS1), U1.15 (VCC), U2.8 (VDD), U3.28 (VCC), U4.27 (~WE), U4.28 (VCC), U5.3 (VCC_0), U5.15 (VCC_1), U5.23 (VCC_2), U5.35 (VCC_3)

Notes on the sheet:
dd8 0v2 - prototype board

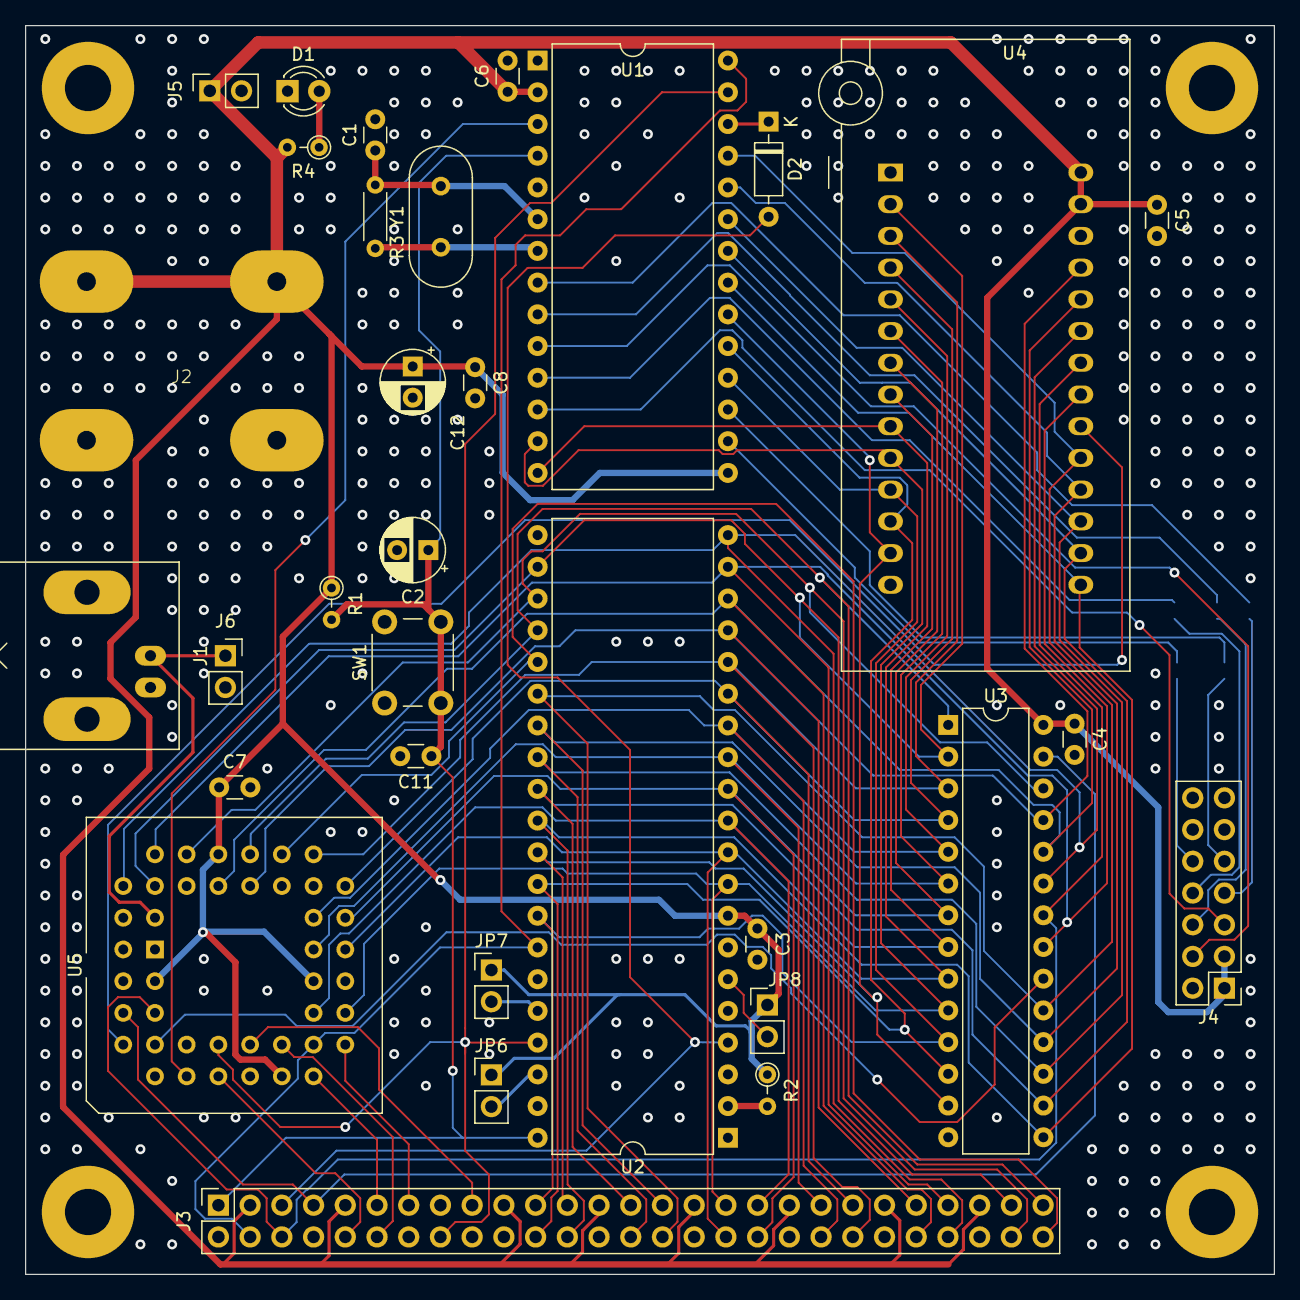
[picture p18: board dd8_0v2.kicad_pcb from above]

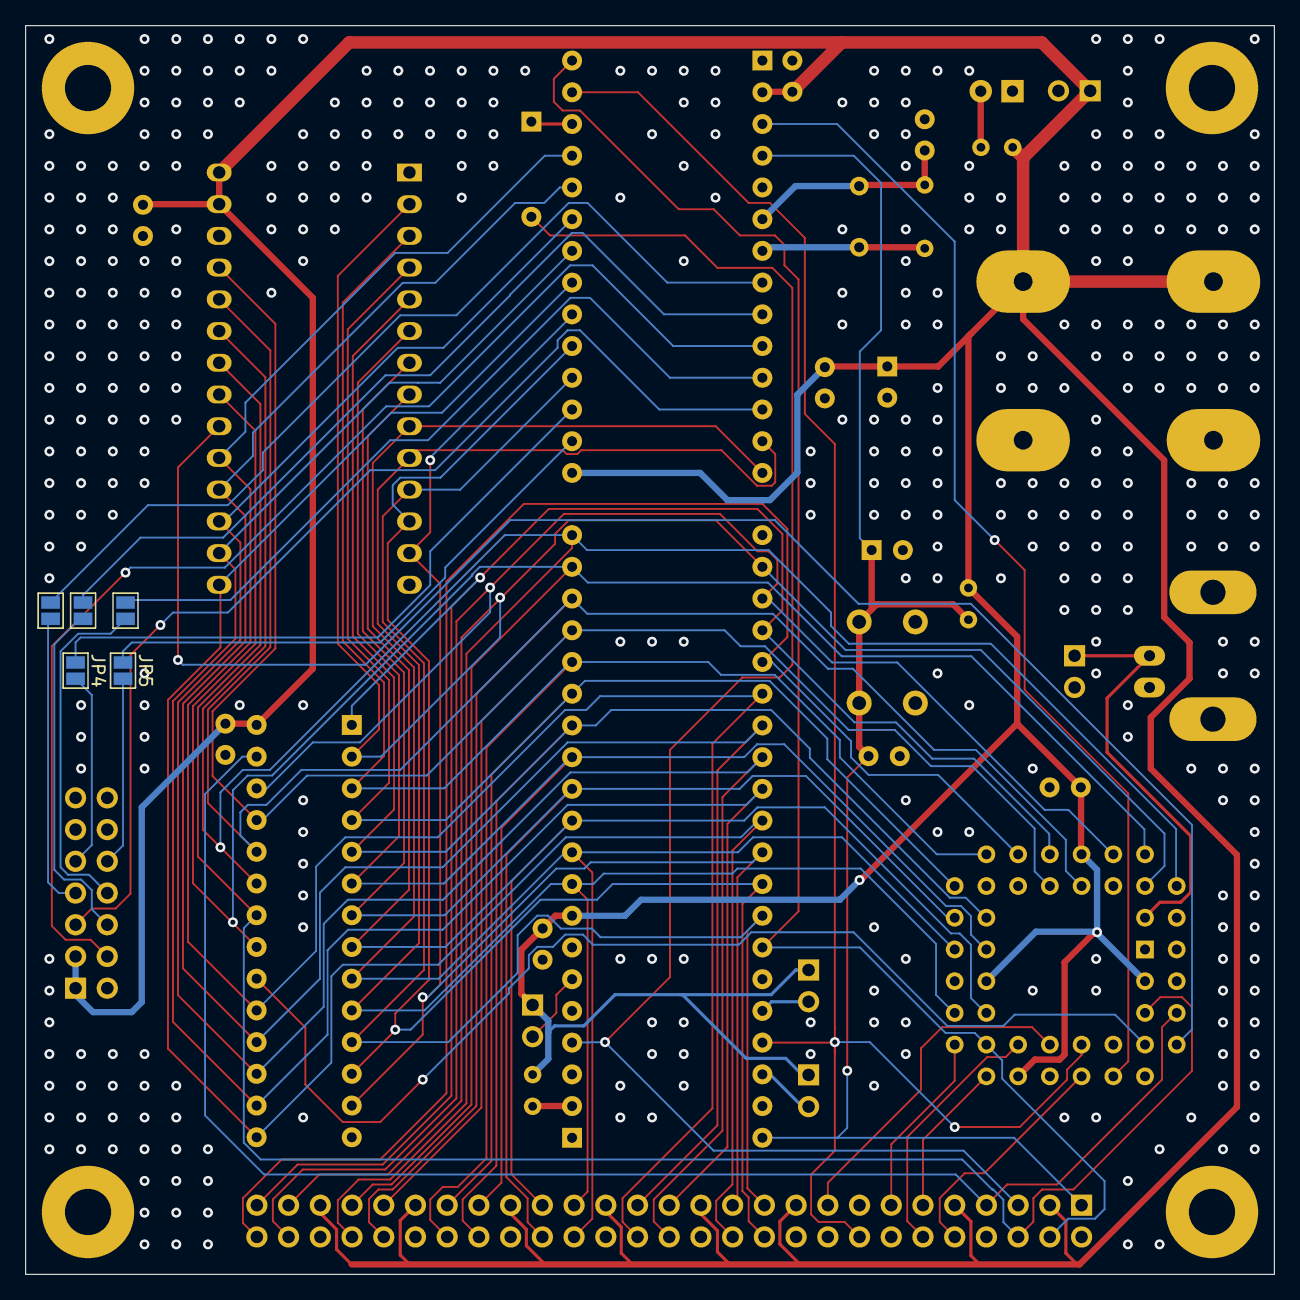
[picture p19: board dd8_0v2.kicad_pcb from below]

Board: 4 copper layers, 100.0 x 100.0 mm, 37 parts (5 on the bottom side), 61 nets.
