ddomurad/dd8/hardware/kicad/dd8_computer/gfx_module.kicad_sch

## KiCad design hardware/kicad/dd8_computer/gfx_module.kicad_sch (2024-12-26)

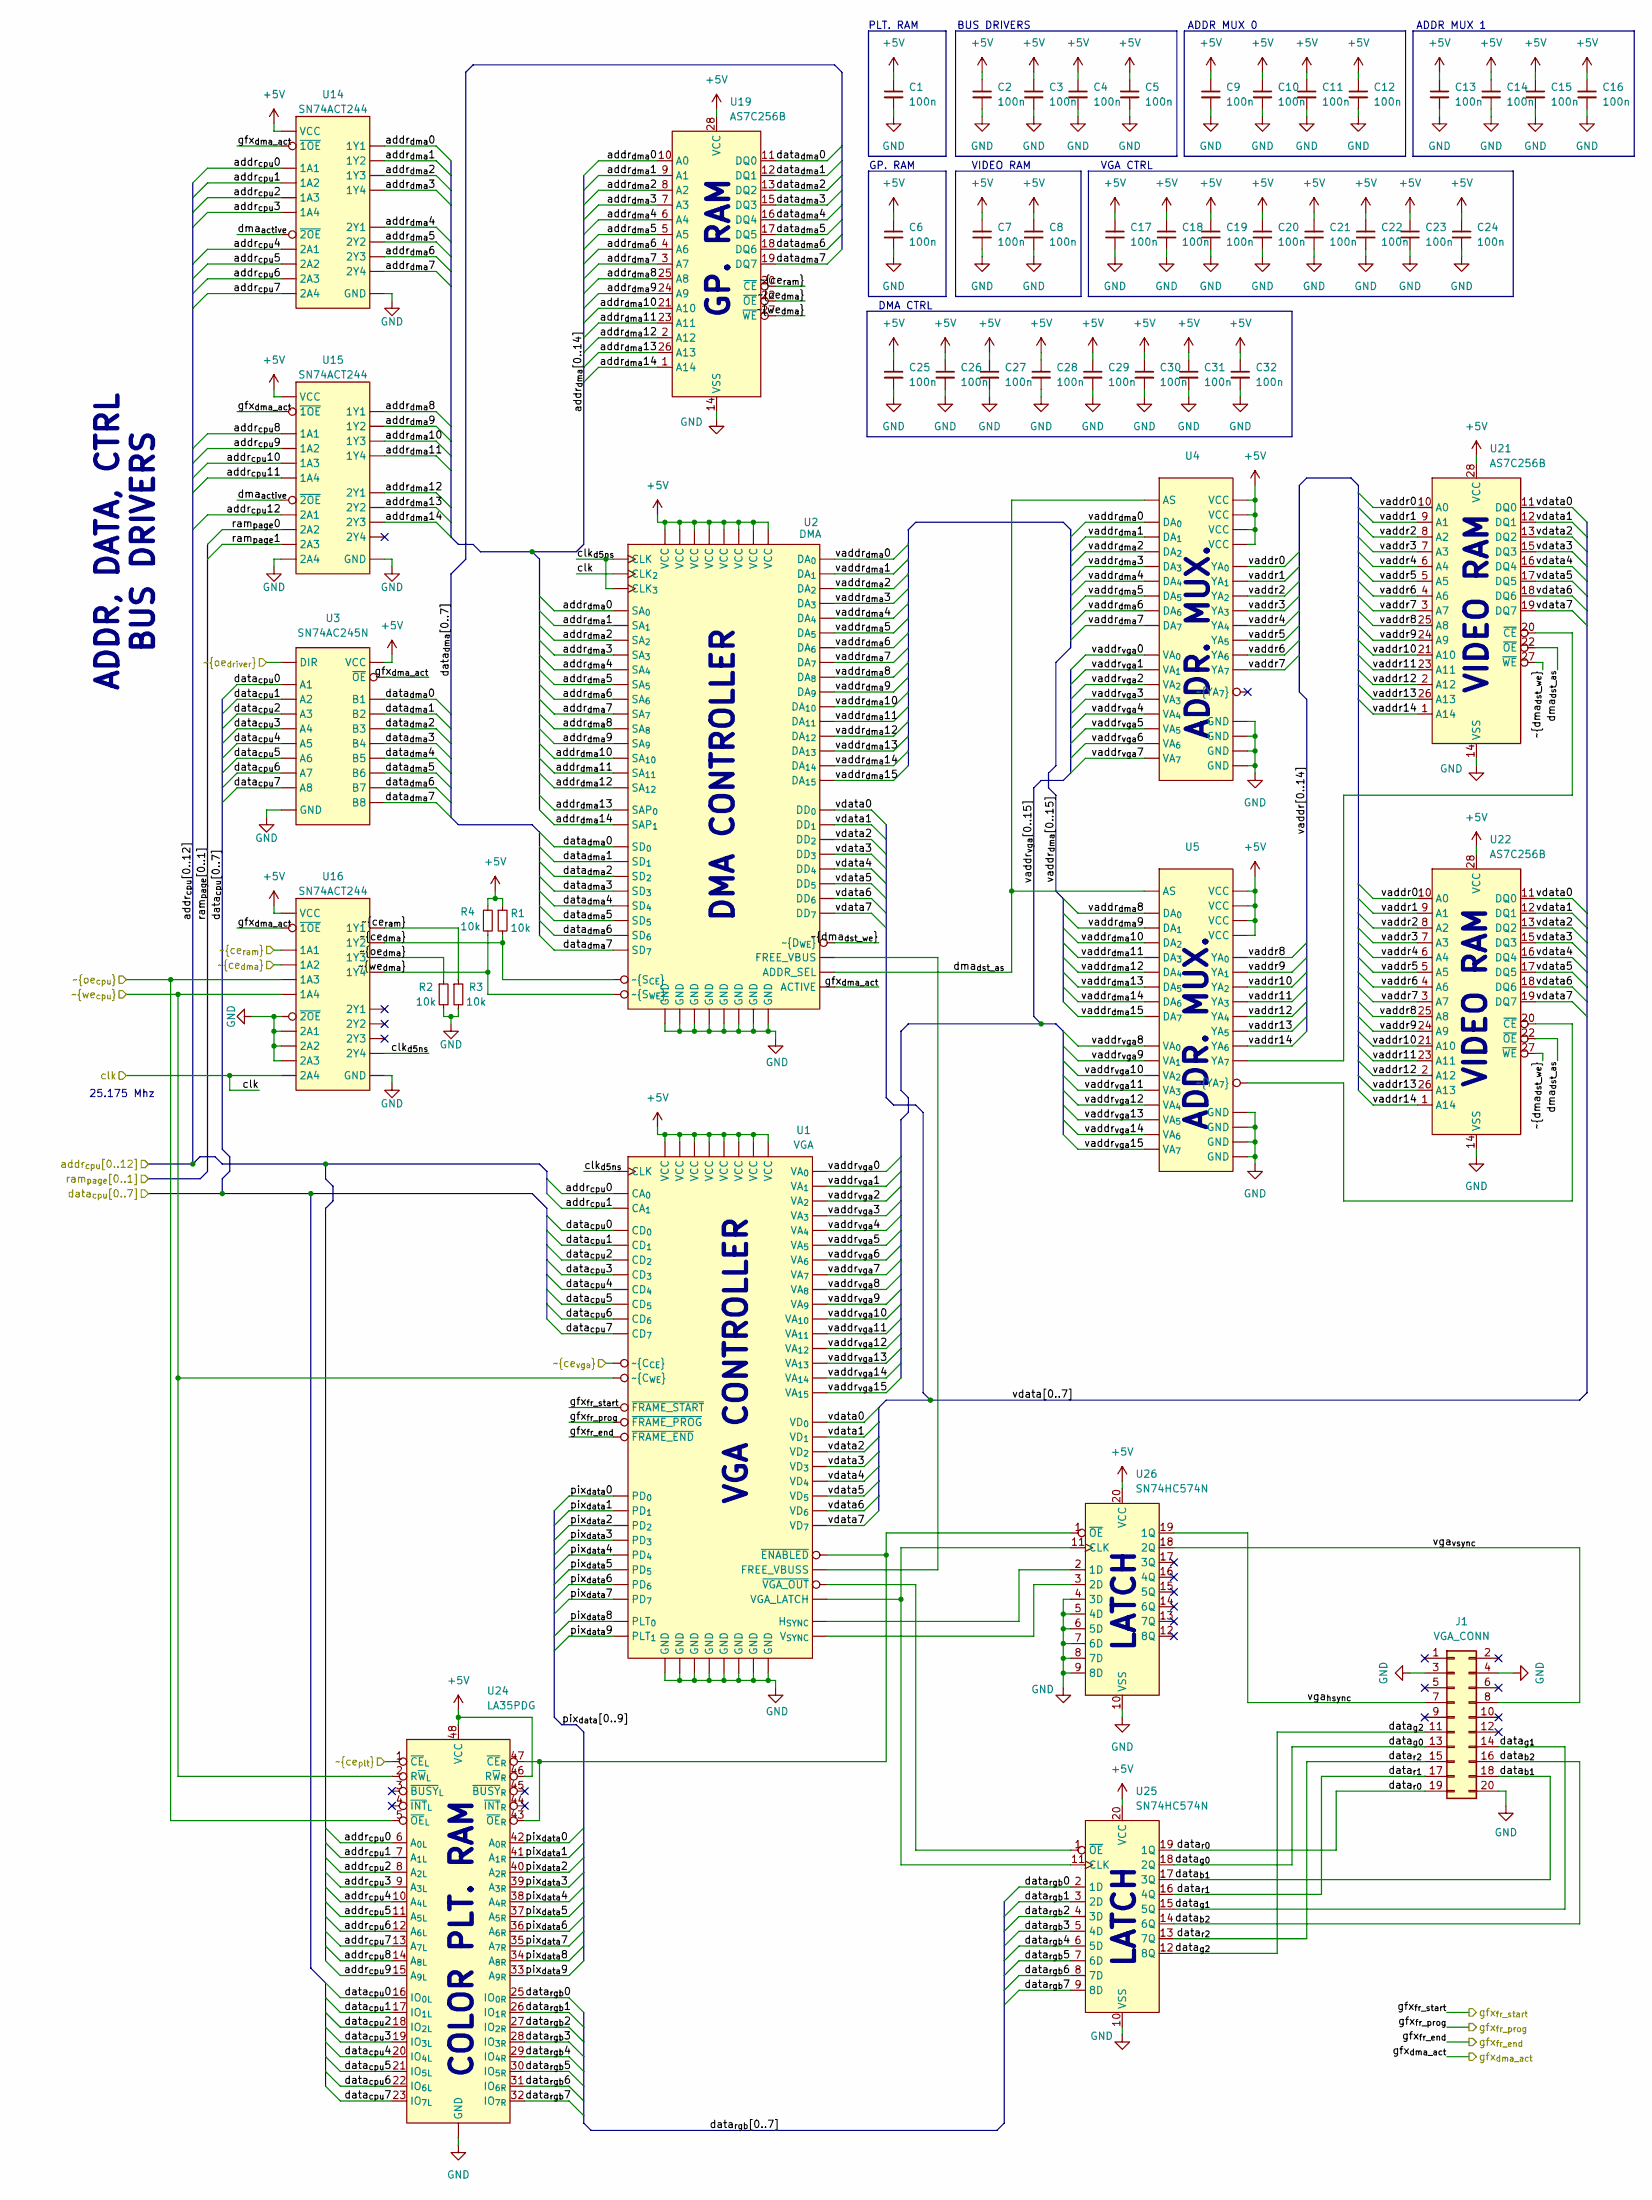
[picture p20: schematic gfx_module.kicad_sch]

Parts:
C1, C2, C3, C4, C5, C6, C7, C8, C9, C10, C11, C12, C13, C14, C15, C16, C17, C18, C19, C20, C21, C22, C23, C24, C25, C26, C27, C28, C29, C30, C31, C32: 100n
J1: VGA_CONN
R1, R2, R3, R4: 10k
U1: VGA
U2: DMA
U3: SN74AC245N
U4, U5: (no value)
U14, U15, U16: SN74ACT244
U19, U21, U22: AS7C256B
U24: LA35PDG
U25, U26: SN74HC574N

Connections:
+5V: C1.1, C2.1, C3.1, C4.1, C5.1, C6.1, C7.1, C8.1, C9.1, C10.1, C11.1, C12.1, C13.1, C14.1, C15.1, C16.1, C17.1, C18.1, C19.1, C20.1, C21.1, C22.1, C23.1, C24.1, C25.1, C26.1, C27.1, C28.1, C29.1, C30.1, C31.1, C32.1, R1.1, R4.1, U1., U2., U3., U4., U5., U14., U15., U16., U19.28 (VCC), U21.28 (VCC), U22.28 (VCC), U24.46 (R~W_{R}), U24.48 (VCC), U25.20 (VCC), U26.20 (VCC)
GND: C1.2, C2.2, C3.2, C4.2, C5.2, C6.2, C7.2, C8.2, C9.2, C10.2, C11.2, C12.2, C13.2, C14.2, C15.2, C16.2, C17.2, C18.2, C19.2, C20.2, C21.2, C22.2, C23.2, C24.2, C25.2, C26.2, C27.2, C28.2, C29.2, C30.2, C31.2, C32.2, J1.3, J1.4, J1.20, R2.2, R3.2, U1., U2., U3., U4., U5., U14., U15., U16., U19.14 (VSS), U21.14 (VSS), U22.14 (VSS), U24. (GND), U25.10 (VSS), U26.4 (3D), U26.5 (4D), U26.6 (5D), U26.7 (6D), U26.8 (7D), U26.9 (8D), U26.10 (VSS)
unnamed: U1., U2., U24.43 (~OE_{R}), U24.47 (~CE_{R}), U25.1 (~OE), U25.11 (CLK), U26.1 (~OE), U26.2 (1D), U26.3 (2D), U26.11 (CLK)
unnamed: U5., U21.20 (~CE)
unnamed: U5., U22.20 (~CE)
addr_{cpu}0: U1., U14., U24.6 (A_{0L})
addr_{cpu}1: U1., U14., U24.7 (A_{1L})
addr_{cpu}2: U14., U24.8 (A_{2L})
addr_{cpu}3: U14., U24.9 (A_{3L})
addr_{cpu}4: U14., U24.10 (A_{4L})
addr_{cpu}5: U14., U24.11 (A_{5L})
addr_{cpu}6: U14., U24.12 (A_{6L})
addr_{cpu}7: U14., U24.13 (A_{7L})
addr_{cpu}8: U15., U24.14 (A_{8L})
addr_{cpu}9: U15., U24.15 (A_{9L})
addr_{cpu}10: U15.
addr_{cpu}11: U15.
addr_{cpu}12: U15.
addr_{dma}0: U2., U14., U19.10 (A0)
addr_{dma}1: U2., U14., U19.9 (A1)
addr_{dma}2: U2., U14., U19.8 (A2)
addr_{dma}3: U2., U14., U19.7 (A3)
addr_{dma}4: U2., U14., U19.6 (A4)
addr_{dma}5: U2., U14., U19.5 (A5)
addr_{dma}6: U2., U14., U19.4 (A6)
addr_{dma}7: U2., U14., U19.3 (A7)
addr_{dma}8: U2., U15., U19.25 (A8)
addr_{dma}9: U2., U15., U19.24 (A9)
addr_{dma}10: U2., U15., U19.21 (A10)
addr_{dma}11: U2., U15., U19.23 (A11)
addr_{dma}12: U2., U15., U19.2 (A12)
addr_{dma}13: U2., U15., U19.26 (A13)
addr_{dma}14: U2., U15., U19.1 (A14)
clk: U2., U16.
clk_{d5ns}: U1., U2., U16.
data_{b1}: J1.18, U25.17 (3Q)
data_{b2}: J1.16, U25.14 (6Q)
data_{cpu}0: U1., U3., U24.16 (IO_{0L})
data_{cpu}1: U1., U3., U24.17 (IO_{1L})
data_{cpu}2: U1., U3., U24.18 (IO_{2L})
data_{cpu}3: U1., U3., U24.19 (IO_{3L})
data_{cpu}4: U1., U3., U24.20 (IO_{4L})
data_{cpu}5: U1., U3., U24.21 (IO_{5L})
data_{cpu}6: U1., U3., U24.22 (IO_{6L})
data_{cpu}7: U1., U3., U24.23 (IO_{7L})
data_{dma}0: U2., U3., U19.11 (DQ0)
data_{dma}1: U2., U3., U19.12 (DQ1)
data_{dma}2: U2., U3., U19.13 (DQ2)
data_{dma}3: U2., U3., U19.15 (DQ3)
data_{dma}4: U2., U3., U19.16 (DQ4)
data_{dma}5: U2., U3., U19.17 (DQ5)
data_{dma}6: U2., U3., U19.18 (DQ6)
data_{dma}7: U2., U3., U19.19 (DQ7)
data_{g0}: J1.13, U25.18 (2Q)
data_{g1}: J1.14, U25.15 (5Q)
data_{g2}: J1.11, U25.12 (8Q)
data_{r0}: J1.19, U25.19 (1Q)
data_{r1}: J1.17, U25.16 (4Q)
data_{r2}: J1.15, U25.13 (7Q)
data_{rgb}0: U24.25 (IO_{0R}), U25.2 (1D)
data_{rgb}1: U24.26 (IO_{1R}), U25.3 (2D)
data_{rgb}2: U24.27 (IO_{2R}), U25.4 (3D)
data_{rgb}3: U24.28 (IO_{3R}), U25.5 (4D)
data_{rgb}4: U24.29 (IO_{4R}), U25.6 (5D)
data_{rgb}5: U24.30 (IO_{5R}), U25.7 (6D)
data_{rgb}6: U24.31 (IO_{6R}), U25.8 (7D)
data_{rgb}7: U24.32 (IO_{7R}), U25.9 (8D)
dma_{active}: U14., U15.
dma_{dst_as}: U2., U4., U5., U21.22 (~OE), U22.22 (~OE)
gfx_{dma_act}: U2., U3., U14., U15., U16.
gfx_{fr_end}: U1.
gfx_{fr_prog}: U1.
gfx_{fr_start}: U1.
pix_{data}0: U1., U24.42 (A_{0R})
pix_{data}1: U1., U24.41 (A_{1R})
pix_{data}2: U1., U24.40 (A_{2R})
pix_{data}3: U1., U24.39 (A_{3R})
pix_{data}4: U1., U24.38 (A_{4R})
pix_{data}5: U1., U24.37 (A_{5R})
pix_{data}6: U1., U24.36 (A_{6R})
pix_{data}7: U1., U24.35 (A_{7R})
pix_{data}8: U1., U24.34 (A_{8R})
pix_{data}9: U1., U24.33 (A_{9R})
ram_{page}0: U15.
ram_{page}1: U15.
vaddr0: U4., U21.10 (A0), U22.10 (A0)
vaddr1: U4., U21.9 (A1), U22.9 (A1)
vaddr2: U4., U21.8 (A2), U22.8 (A2)
vaddr3: U4., U21.7 (A3), U22.7 (A3)
vaddr4: U4., U21.6 (A4), U22.6 (A4)
vaddr5: U4., U21.5 (A5), U22.5 (A5)
vaddr6: U4., U21.4 (A6), U22.4 (A6)
vaddr7: U4., U21.3 (A7), U22.3 (A7)
vaddr8: U5., U21.25 (A8), U22.25 (A8)
vaddr9: U5., U21.24 (A9), U22.24 (A9)
vaddr10: U5., U21.21 (A10), U22.21 (A10)
vaddr11: U5., U21.23 (A11), U22.23 (A11)
vaddr12: U5., U21.2 (A12), U22.2 (A12)
vaddr13: U5., U21.26 (A13), U22.26 (A13)
vaddr14: U5., U21.1 (A14), U22.1 (A14)
vaddr_{dma}0: U2., U4.
vaddr_{dma}1: U2., U4.
vaddr_{dma}2: U2., U4.
vaddr_{dma}3: U2., U4.
vaddr_{dma}4: U2., U4.
vaddr_{dma}5: U2., U4.
vaddr_{dma}6: U2., U4.
vaddr_{dma}7: U2., U4.
vaddr_{dma}8: U2., U5.
vaddr_{dma}9: U2., U5.
vaddr_{dma}10: U2., U5.
vaddr_{dma}11: U2., U5.
vaddr_{dma}12: U2., U5.
vaddr_{dma}13: U2., U5.
vaddr_{dma}14: U2., U5.
vaddr_{dma}15: U2., U5.
vaddr_{vga}0: U1., U4.
vaddr_{vga}1: U1., U4.
vaddr_{vga}2: U1., U4.
vaddr_{vga}3: U1., U4.
vaddr_{vga}4: U1., U4.
vaddr_{vga}5: U1., U4.
vaddr_{vga}6: U1., U4.
vaddr_{vga}7: U1., U4.
vaddr_{vga}8: U1., U5.
vaddr_{vga}9: U1., U5.
vaddr_{vga}10: U1., U5.
vaddr_{vga}11: U1., U5.
vaddr_{vga}12: U1., U5.
vaddr_{vga}13: U1., U5.
vaddr_{vga}14: U1., U5.
vaddr_{vga}15: U1., U5.
vdata0: U1., U2., U21.11 (DQ0), U22.11 (DQ0)
vdata1: U1., U2., U21.12 (DQ1), U22.12 (DQ1)
vdata2: U1., U2., U21.13 (DQ2), U22.13 (DQ2)
vdata3: U1., U2., U21.15 (DQ3), U22.15 (DQ3)
vdata4: U1., U2., U21.16 (DQ4), U22.16 (DQ4)
vdata5: U1., U2., U21.17 (DQ5), U22.17 (DQ5)
vdata6: U1., U2., U21.18 (DQ6), U22.18 (DQ6)
vdata7: U1., U2., U21.19 (DQ7), U22.19 (DQ7)
vga_{hsync}: J1.7, U26.19 (1Q)
vga_{vsync}: J1.8, U26.18 (2Q)
~ce_{dma}: R1.2, U2., U16.
~ce_{plt}: U24.1 (~CE_{L})
~ce_{ram}: R3.1, U16., U19.20 (~CE)
~ce_{vga}: U1.
~dma_{dst_we}: U2., U21.27 (~WE), U22.27 (~WE)
~oe_{cpu}: U16., U24.5 (~OE_{L})
~oe_{dma}: R2.1, U16., U19.22 (~OE)
~oe_{driver}: U3.
~we_{cpu}: U1., U16., U24.2 (R~W_{L})
~we_{dma}: R4.2, U2., U16., U19.27 (~WE)

Notes on the sheet:
LATCH
BUS DRIVERS
VGA CONTROLLER
ADDR. MUX.
ADDR, DATA, CTRL BUS DRIVERS
VGA CTRL
ADDR MUX 0
25.175 Mhz
GP. RAM
ADDR MUX 1
VIDEO RAM
PLT. RAM
DMA CONTROLLER
COLOR PLT. RAM
DMA CTRL
