ddomurad/dd8/hardware/kicad/dd8_computer/vga_module.kicad_sch

## KiCad design hardware/kicad/dd8_computer/vga_module.kicad_sch (2024-11-05)

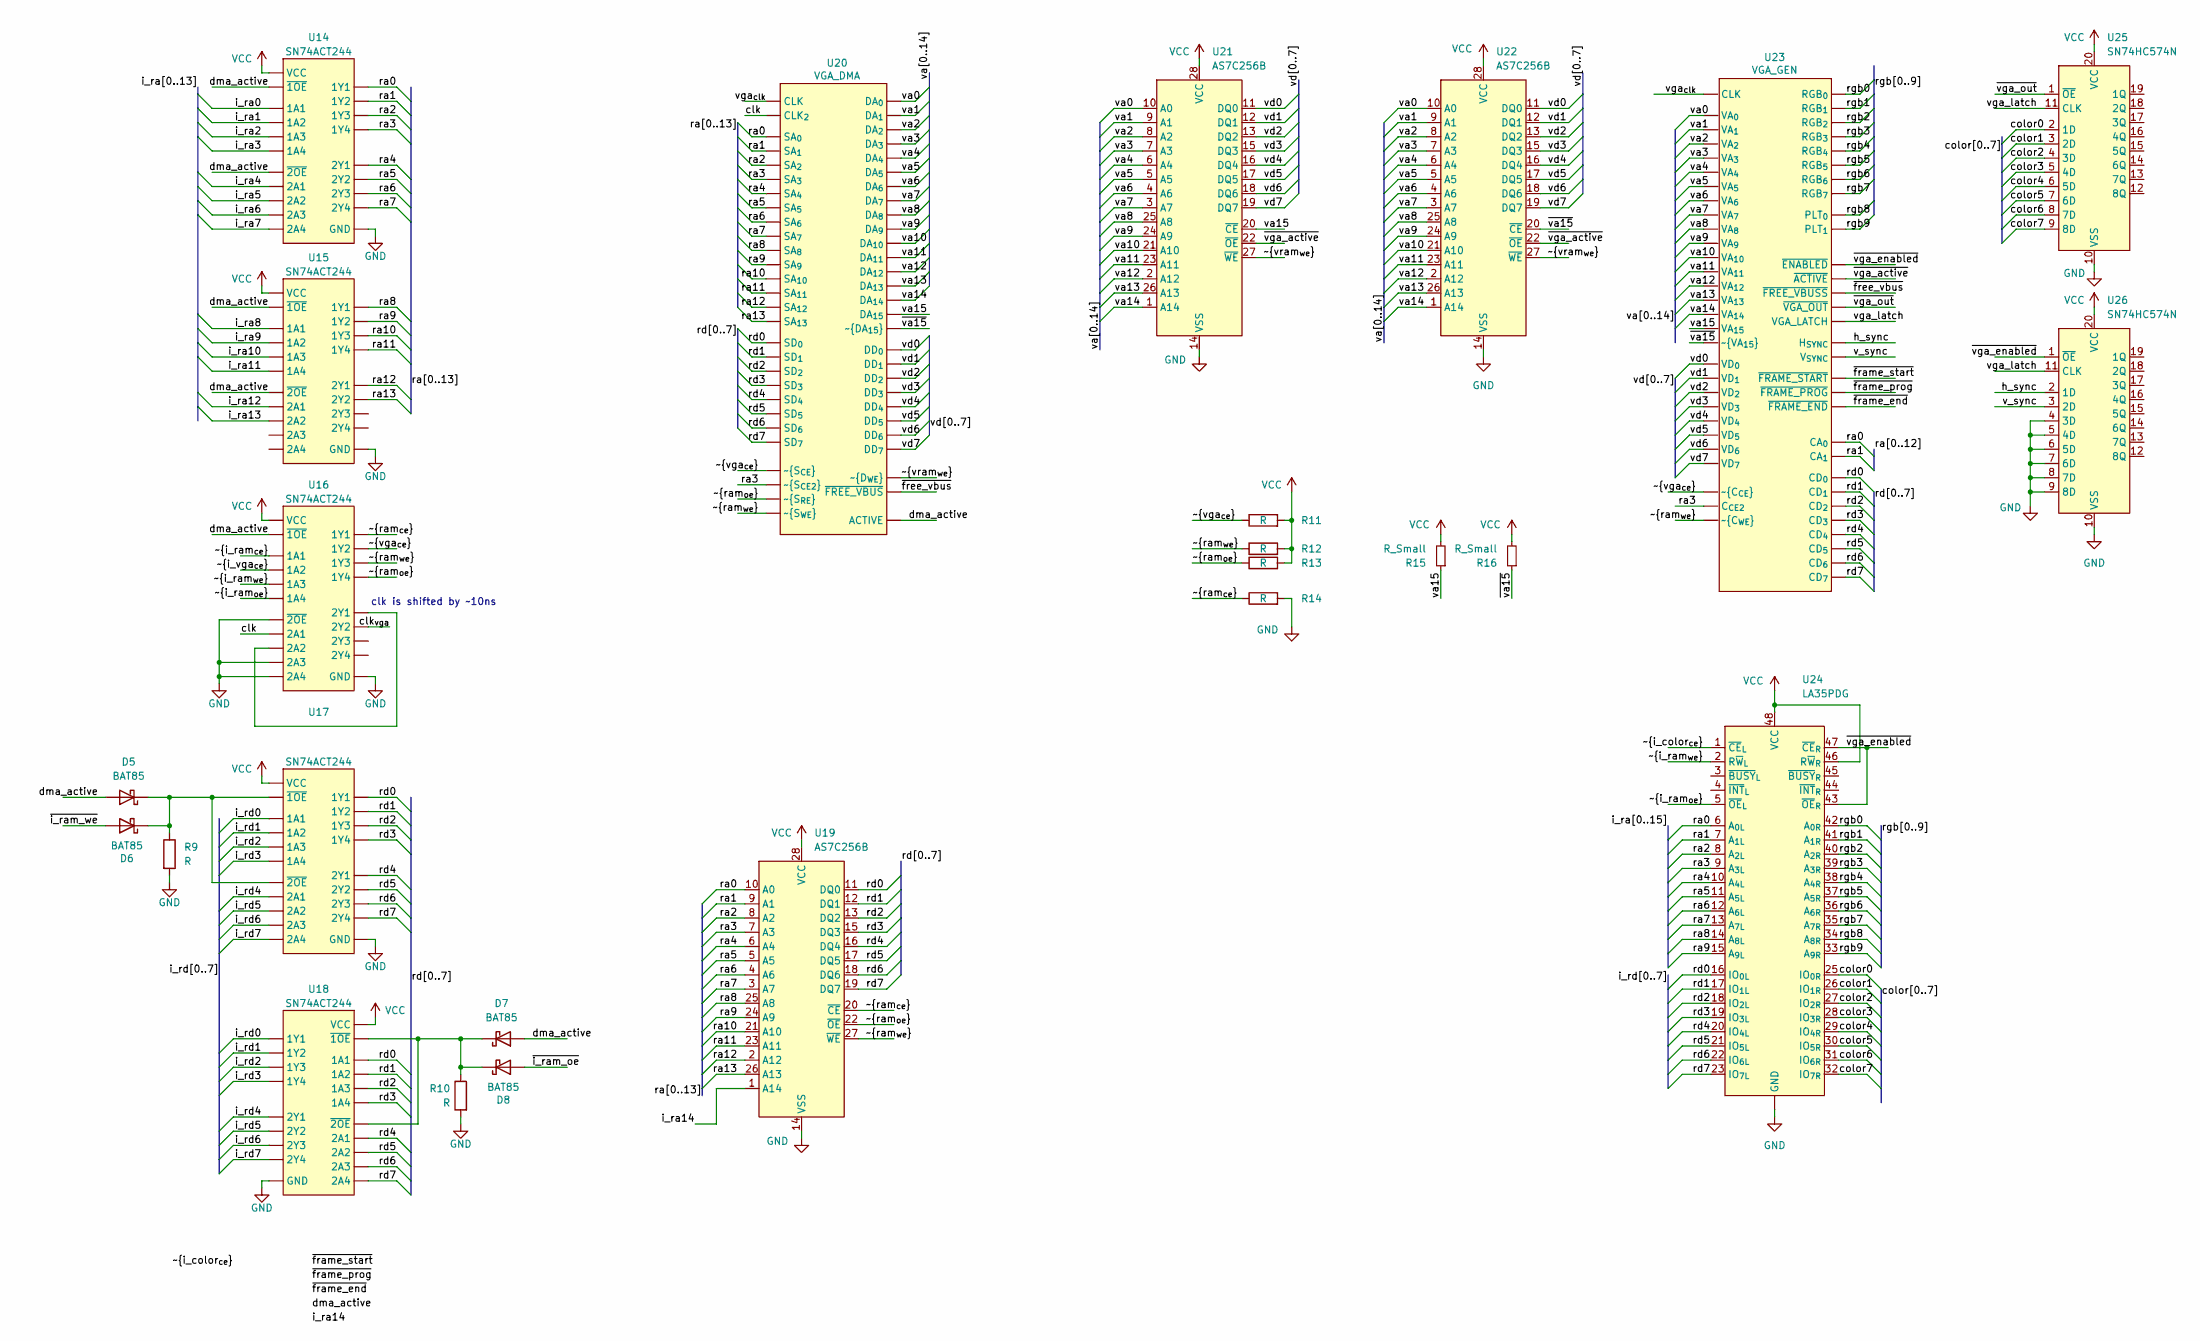
[picture p21: schematic vga_module.kicad_sch]

Parts:
D5, D6, D7, D8: BAT85
R9, R10, R11, R12, R13, R14: R
R15, R16: R_Small
U14, U15, U16, U17, U18: SN74ACT244
U19, U21, U22: AS7C256B
U20: VGA_DMA
U23: VGA_GEN
U24: LA35PDG
U25, U26: SN74HC574N

Connections:
GND: R9.2, R10.2, R14.2, U14., U15., U16., U17., U18., U19.14 (VSS), U21.14 (VSS), U22.14 (VSS), U24. (GND), U25.10 (VSS), U26.4 (3D), U26.5 (4D), U26.6 (5D), U26.7 (6D), U26.8 (7D), U26.9 (8D), U26.10 (VSS)
unnamed: D5.1 (K), D6.1 (K), R9.1, U17.
unnamed: D7.1 (K), D8.1 (K), R10.1, U18.
VCC: R11.2, R12.2, R13.2, R15.2, R16.2, U14., U15., U16., U17., U18., U19.28 (VCC), U21.28 (VCC), U22.28 (VCC), U24.46 (R~W_{R}), U24.48 (VCC), U25.20 (VCC), U26.20 (VCC)
clk: U16., U20.
clk_{vga}: U16.
color0: U24.25 (IO_{0R}), U25.2 (1D)
color1: U24.26 (IO_{1R}), U25.3 (2D)
color2: U24.27 (IO_{2R}), U25.4 (3D)
color3: U24.28 (IO_{3R}), U25.5 (4D)
color4: U24.29 (IO_{4R}), U25.6 (5D)
color5: U24.30 (IO_{5R}), U25.7 (6D)
color6: U24.31 (IO_{6R}), U25.8 (7D)
color7: U24.32 (IO_{7R}), U25.9 (8D)
dma_active: D5.2 (A), D7.2 (A), U14., U15., U16., U20.
h_sync: U23., U26.2 (1D)
i_ra0: U14.
i_ra1: U14.
i_ra2: U14.
i_ra3: U14.
i_ra4: U14.
i_ra5: U14.
i_ra6: U14.
i_ra7: U14.
i_ra8: U15.
i_ra9: U15.
i_ra10: U15.
i_ra11: U15.
i_ra12: U15.
i_ra13: U15.
i_ra14: U19.1 (A14)
i_rd0: U17., U18.
i_rd1: U17., U18.
i_rd2: U17., U18.
i_rd3: U17., U18.
i_rd4: U17., U18.
i_rd5: U17., U18.
i_rd6: U17., U18.
i_rd7: U17., U18.
ra0: U14., U19.10 (A0), U20., U23., U24.6 (A_{0L})
ra1: U14., U19.9 (A1), U20., U23., U24.7 (A_{1L})
ra2: U14., U19.8 (A2), U20., U24.8 (A_{2L})
ra3: U14., U19.7 (A3), U20., U23., U24.9 (A_{3L})
ra4: U14., U19.6 (A4), U20., U24.10 (A_{4L})
ra5: U14., U19.5 (A5), U20., U24.11 (A_{5L})
ra6: U14., U19.4 (A6), U20., U24.12 (A_{6L})
ra7: U14., U19.3 (A7), U20., U24.13 (A_{7L})
ra8: U15., U19.25 (A8), U20., U24.14 (A_{8L})
ra9: U15., U19.24 (A9), U20., U24.15 (A_{9L})
ra10: U15., U19.21 (A10), U20.
ra11: U15., U19.23 (A11), U20.
ra12: U15., U19.2 (A12), U20.
ra13: U15., U19.26 (A13), U20.
rd0: U17., U18., U19.11 (DQ0), U20., U23., U24.16 (IO_{0L})
rd1: U17., U18., U19.12 (DQ1), U20., U23., U24.17 (IO_{1L})
rd2: U17., U18., U19.13 (DQ2), U20., U23., U24.18 (IO_{2L})
rd3: U17., U18., U19.15 (DQ3), U20., U23., U24.19 (IO_{3L})
rd4: U17., U18., U19.16 (DQ4), U20., U23., U24.20 (IO_{4L})
rd5: U17., U18., U19.17 (DQ5), U20., U23., U24.21 (IO_{5L})
rd6: U17., U18., U19.18 (DQ6), U20., U23., U24.22 (IO_{6L})
rd7: U17., U18., U19.19 (DQ7), U20., U23., U24.23 (IO_{7L})
rgb0: U23., U24.42 (A_{0R})
rgb1: U23., U24.41 (A_{1R})
rgb2: U23., U24.40 (A_{2R})
rgb3: U23., U24.39 (A_{3R})
rgb4: U23., U24.38 (A_{4R})
rgb5: U23., U24.37 (A_{5R})
rgb6: U23., U24.36 (A_{6R})
rgb7: U23., U24.35 (A_{7R})
rgb8: U23., U24.34 (A_{8R})
rgb9: U23., U24.33 (A_{9R})
v_sync: U23., U26.3 (2D)
va0: U20., U21.10 (A0), U22.10 (A0), U23.
va1: U20., U21.9 (A1), U22.9 (A1), U23.
va2: U20., U21.8 (A2), U22.8 (A2), U23.
va3: U20., U21.7 (A3), U22.7 (A3), U23.
va4: U20., U21.6 (A4), U22.6 (A4), U23.
va5: U20., U21.5 (A5), U22.5 (A5), U23.
va6: U20., U21.4 (A6), U22.4 (A6), U23.
va7: U20., U21.3 (A7), U22.3 (A7), U23.
va8: U20., U21.25 (A8), U22.25 (A8), U23.
va9: U20., U21.24 (A9), U22.24 (A9), U23.
va10: U20., U21.21 (A10), U22.21 (A10), U23.
va11: U20., U21.23 (A11), U22.23 (A11), U23.
va12: U20., U21.2 (A12), U22.2 (A12), U23.
va13: U20., U21.26 (A13), U22.26 (A13), U23.
va14: U20., U21.1 (A14), U22.1 (A14), U23.
va15: R15.1, U20., U21.20 (~CE), U23.
vd0: U20., U21.11 (DQ0), U22.11 (DQ0), U23.
vd1: U20., U21.12 (DQ1), U22.12 (DQ1), U23.
vd2: U20., U21.13 (DQ2), U22.13 (DQ2), U23.
vd3: U20., U21.15 (DQ3), U22.15 (DQ3), U23.
vd4: U20., U21.16 (DQ4), U22.16 (DQ4), U23.
vd5: U20., U21.17 (DQ5), U22.17 (DQ5), U23.
vd6: U20., U21.18 (DQ6), U22.18 (DQ6), U23.
vd7: U20., U21.19 (DQ7), U22.19 (DQ7), U23.
vga_latch: U23., U25.11 (CLK), U26.11 (CLK)
vga_{clk}: U20., U23.
~frame_end: U23.
~frame_prog: U23.
~frame_start: U23.
~free_vbus: U20., U23.
~i_color_{ce}: U24.1 (~CE_{L})
~i_ram_oe: D8.2 (A)
~i_ram_we: D6.2 (A)
~i_ram_{ce}: U16.
~i_ram_{oe}: U16., U24.5 (~OE_{L})
~i_ram_{we}: U16., U24.2 (R~W_{L})
~i_vga_{ce}: U16.
~ram_{ce}: R14.1, U16., U19.20 (~CE)
~ram_{oe}: R13.1, U16., U19.22 (~OE), U20.
~ram_{we}: R12.1, U16., U19.27 (~WE), U20., U23.
~va15: R16.1, U20., U22.20 (~CE), U23.
~vga_active: U21.22 (~OE), U22.22 (~OE), U23.
~vga_enabled: U23., U24.43 (~OE_{R}), U24.47 (~CE_{R}), U26.1 (~OE)
~vga_out: U23., U25.1 (~OE)
~vga_{ce}: R11.1, U16., U20., U23.
~vram_{we}: U20., U21.27 (~WE), U22.27 (~WE)

Notes on the sheet:
clk is shifted by ~10ns
