ddomurad/dd8/hardware/0v2/vhdl/board_ctrl.vhdl

library IEEE;
use IEEE.std_logic_1164.all;
-- use IEEE.numeric_std.all;

entity board_ctrl is
  port (
    clk       : in  std_logic;
    rw        : in  std_logic;
    a         : in  std_logic_vector(15 downto 0);

    ce_rom_b  : out std_logic;          
    ce_ram_b  : out std_logic;          
    ce_uart_b : out std_logic;          
    we_b      : out std_logic;
    oe_b      : out std_logic;
    r0        : out std_logic;
    r1        : out std_logic;
    r2        : out std_logic;
    r3        : out std_logic;
    clk_aux   : out std_logic;
    clk2      : out std_logic
  );

end entity board_ctrl;

architecture rtl of board_ctrl is
  signal i_ce_uart : std_logic;
begin
    ce_ram_b <= a(15); -- 0x0000 - 0x7FFF
    ce_uart_b <= not a(15) or a(14); -- 0x8000 - 0xBFFF
    ce_rom_b <= not (a(15) and a(14)); -- 0xE000 - 0xFFFF

    oe_b <= not (rw and clk);
    we_b <= not clk or rw;

    clk_aux <= clk;
    clk2 <= clk;

    r0 <= '0';
    r1 <= '0';
    r2 <= '0';
    r3 <= '0';

end architecture rtl;
