ddomurad/dd8/hardware/gfx_module/tools/gfx_vga/def.h

#ifndef __DEF_H
#define __DEF_H

#define ADDR_L_DDR DDRA
#define ADDR_L_PORT PORTA

#define ADDR_H_DDR DDRC
#define ADDR_H_PORT PORTC

#define DATA_DDR DDRL
#define DATA_PORT PORTL

#define CTRL_DDR DDRK
#define CTRL_PORT PORTK
#define CTRL_PIN PINK

#define CTRL_CRAM_CS_B_PIN 0
#define CTRL_VRAM_CS_B_PIN 1
#define CTRL_WE_B_PIN 2

#endif //__DEF_H
