ddomurad/dd8/tools/asm/tests/res/simple_tests/example.asm

        brk
        ora [0xff,x]
        .db 0x02, 0x03

        tsb 0xff
        ora 0xff
        asl 0xff
        rmb 0, 0xff

        php
        orai 0xff
        asl a
        .db 0x0b
        tsb 0xffff
        ora 0xffff
        asl 0xffff
        bbr 0, 0xff, [-3] ; make this better pls!!!!
lbl1:
        bpl lbl1
        ora [0xff],y
        ora [0xff]
        .db 0x13
        trb 0xff
        ora 0xff,x
        asl 0xff,x
        rmb 1, 0xff

        clc
        ora 0xffff,y
        inc a
        .db 0x1b
        trb 0xffff
        ora 0xffff,x
        asl 0xffff,x
        bbr 1, 0xff, [-3]

        jsr 0xffff
        and [0xff,x]
        .db 0x22, 0x23

        bit 0xff
        and 0xff
        rol 0xff
        rmb 2, 0xff

        plp
        andi 0xff
        rol a
        .db 0x2b
        bit 0xffff
        and 0xffff
        rol 0xffff
        bbr 2, 0xff, [-3]
lbl2:
        bmi lbl2
        and [0xff],y
        and [0xff]
        .db 0x33
        bit 0xff,x
        and 0xff,x
        rol 0xff,x
        rmb 3, 0xff

        sec
        and 0xffff,y
        dec a
        .db 0x3b
        bit 0xffff,x
        and 0xffff,x
        rol 0xffff,x
        bbr 3, 0xff, [-3]

        rti
        eor [0xff,x]
        .db 0x42, 0x43, 0x44


        eor 0xff
        lsr 0xff
        rmb 4, 0xff

        pha
        eori 0xff
        lsr a
        .db 0x4b
        jmp 0xffff
        eor 0xffff
        lsr 0xffff
        bbr 4, 0xff, [-3]
lbl3:
        bvc lbl3
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
lbl9:
        beq lbl9
        sbc [0xff],y
        sbc [0xff]
        .db 0xf3, 0xf4

        sbc 0xff,x
        inc 0xff,x
        smb 7, 0xff

        sed
        sbc 0xffff,y
        plx
        .db 0xfb, 0xfc

        sbc 0xffff,x
        inc 0xffff,x
        bbs 7, 0xff, [-3]
