ddomurad/dd8/tools/ard_rom/hex_reader.h

// #ifndef __HEX_READER
// #define __HEX_READER
//
// #include <stdint.h>
//
//
// uint8_t hex_write_to_rom_memory(uint8_t *rom, uint16_t addr_offset,
//                                 uint16_t rom_size, char *hex,
//                                 uint16_t hex_size);
// #endif //__HEX_READER
