ddomurad/dd8/(commit log)

2023-10-01 Arduino 6502 interface
2023-10-03 Initial assembler implementations
2023-10-22 Assembler updates
2023-10-23 Updates, fixes and refactoring
    [all_inst.asm, example.asm]
2023-12-10 dd8 v0.1 updated
    [dd8_0v1.kicad_sch, keypad_ctrl.kicad_sch]
2023-12-15 Arduino ROM emulator
    [dd8_0v1.kicad_sch]
2024-01-06 Work on 0v2
    [dd8_0v2.kicad_pcb, dd8_0v2.kicad_sch]
2024-02-25 A lot of updates
    [core_board.dxf, core_board_alt.dxf, core_board_bkp.dxf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]
2024-03-10 test additional case
2024-03-10 fix nested templates listing
    [templates.asm]
2024-06-09 gfx poc
    [EpmDevBoard.kicad_pcb, EpmDevBoard.kicad_sch]
2024-11-05 Major graphics card update
    [EpmDevBoard-B_Cu.gbl, EpmDevBoard-B_Mask.gbs, EpmDevBoard-B_Paste.gbp, EpmDevBoard-B_Silks.gbo, EpmDevBoard-Edge_Cuts.gm1, EpmDevBoard-F_Cu.gtl, EpmDevBoard-F_Mask.gts, EpmDevBoard-F_Paste.gtp]
